yairbon/HomeGuard/README.md

# HomeGuard — מערכת אבטחה היברידית מרובת שכבות

פרויקט גמר, קורס חשיפה לחומרה. שותפים: גיא בר, יאיר בונפיל.

## תקציר
מערכת אבטחה לבית המשלבת מחשוב קצה על ESP32 עם עיבוד נתונים בפייתון.
**שלושה לוחות ESP32** (לוח חיישנים עם חיישן מרחק וחיישן רעידות, לוח דלת עם
קודן וזמזמים, ולוח מצלמה) מדווחים לבקנד FastAPI מרכזי, שמאחד את התקשורת,
מריץ זיהוי פנים, ומשרת אפליקציית Flutter לשליטה מרחוק ולהתראות. בתיקיית
`esp32/` יש גם סקיצה עצמאית לחיישן הרעידות, שלא נצרבת על לוח נפרד בהתקנה
הסופית (החיישן יושב על לוח החיישנים).

## מבנה תיקיות
- `esp32/` — קושחת C++ לבקרים (ראה `esp32/README.md`)
- `python/` — בקנד FastAPI + זיהוי פנים (ראה `python/README.md`)
- `app/` — אפליקציית Flutter (Android) לשליטה מרחוק והתראות
- `docs/` — מסמכי הפרויקט (כולל טופס ההצעה המקורי)
- `scripts/` — סקריפטי התקנה לסביבת הפיתוח (ראה למטה)

**הערה:** התיקייה ממוקמת ב-`C:\dev\HomeGuard` בכוונה (לא תחת `C:\Users\<username>`) —
כלי Android/Gradle נשברים לעיתים כשהנתיב מכיל תווים לא-ASCII (כמו שם משתמש בעברית).

## ארכיטקטורה

```
  ┌───────────────────┐   ┌──────────────────┐   ┌────────────────────────┐
  │ ultrasonic_sensor │   │ vibration_sensor │   │ door_keypad_controller │
  │    (HC-SR04)      │   │     (SW420)      │   │  קודן + חיישן דלת      │
  └─────────┬─────────┘   └────────┬─────────┘   └───────────┬────────────┘
            │  POST /esp32/*       │                         │  ▲
            │  + X-Device-Key      │                         │  │ POST /arm /disarm
            └──────────────┬───────┴─────────────────────────┘  │ /trigger-alarm
                           │                                     │ /keypad-pin
  ┌───────────────────┐    │                                     │ + X-Device-Key
  │    esp32_cam      │    │                                     │
  │  (AI-Thinker)     │────┤  POST /camera/recognize             │
  │  + שרת MJPEG      │◀───┤  ◀── GET /stream (הבקנד מושך)      │
  └───────────────────┘    ▼                                     │
                 ┌──────────────────────┐──────────────────────-─┘
                 │  בקנד FastAPI        │
                 │  (python/)           │  ← זיהוי פנים (YuNet + SFace)
                 └──────────┬───────────┘
                            │  REST + WebSocket /ws
                            │  + Authorization: Bearer <token>
                            ▼
                 ┌──────────────────────┐
                 │  אפליקציית Flutter   │
                 │  (app/, Android)     │
                 └──────────────────────┘
```

שני הלוחות הראשונים "טיפשים" בכוונה — הם לא יודעים אם המערכת דרוכה, פשוט
מדווחים, והבקנד מחליט אם זה משנה. לוח הקודן הוא הסמכות לדריכה/נטרול (יש לו
את הקודן הפיזי), ולכן הוא היחיד שגם מקבל פקודות ולא רק שולח. לוח המצלמה
דוחף פריימים לזיהוי פנים וגם מגיש זרם MJPEG שהבקנד מעביר לאפליקציה; בכוונה
הוא לא שולח heartbeat.

## אבטחה

זו מערכת אזעקה, ולכן שום endpoint לא פתוח:

- **האפליקציה** מתחברת עם סיסמה ומקבלת session token (תקף 12 שעות), שנשלח
  ככותרת `Authorization: Bearer` בכל בקשה. הסיסמה נשמרת כ-hash (scrypt עם
  salt), לא בטקסט גלוי. שינוי סיסמה מבטל את כל הסשנים האחרים.
- **הלוחות** מזדהים עם מפתח משותף (`X-Device-Key`) שמוגדר ב-`esp32/secrets.h`.
  בלעדיו אי אפשר לזייף דיווח פריצה — או לזייף דיווח "המערכת נוטרלה".
- **נעילה** אחרי 3 ניסיונות שגויים, על `/login` וגם על `/change-password`.
- ה-endpoints הפתוחים הם `/health`, `/login`, ותיעוד ה-API שלFastAPI
  (`/docs`, `/redoc`, `/openapi.json`). כל השאר דורש אישור.

**סודות לא נכנסים לגיט:** העתק את `esp32/secrets.h.example` לכל אחת
מכל תיקיית סקיצה שנצרבת על לוח בשם `secrets.h` ומלא את הערכים (פרטי WiFi, כתובת
הבקנד, מפתח המכשיר, קוד הקודן). לוח המצלמה צריך אותו כמו כל השאר — בלעדיו
הוא לא מזדהה מול הבקנד. `KEYPAD_PIN` הוא רק ברירת המחדל לצריבה: אחרי
ההתקנה אפשר לשנות את הקוד ממסך ההגדרות באפליקציה, והוא נשמר ב-NVS על הלוח.

## הרצה

בקנד:
```powershell
cd python
python -m venv venv
.\venv\Scripts\pip.exe install -r requirements.txt
.\venv\Scripts\python.exe -m uvicorn backend.main:app --host 0.0.0.0 --port 8000
```
בהרצה ראשונה הוא ייצר מפתח מכשיר וידפיס אותו ללוג — זה מה שצריך להיכנס
ל-`secrets.h`. פירוט מלא: `python/README.md`.

אפליקציה: `/flutter-build` (custom command) או ידנית דרך WSL2 (ראה "סביבת
פיתוח" למטה). את כתובת הבקנד עורכים במסך Settings באפליקציה.

## בדיקות

| מה | איך | היקף |
|---|---|---|
| בקנד, מהיר | `pytest` מתוך `python/` | 285 בדיקות in-process, בלי שרת |
| בקנד, מקצה לקצה | `python simulate.py` מול שרת **נפרד** (לא האמיתי — ראה `python/README.md`) | 95 בדיקות דרך סוקט אמיתי |
| בקנד, lint | `ruff check .` | |
| אפליקציה | `flutter analyze` + `flutter test` | |

הכול רץ אוטומטית ב-GitHub Actions (`.github/workflows/ci.yml`).

## סביבת פיתוח
Flutter SDK, Android SDK ו-JDK 17 מותקנים תחת `C:\dev`. לשחזור במחשב חדש:
`.\scripts\setup-windows.ps1`. אם הבנייה נשברת עם
`Unable to establish loopback connection` — זו תקלת Winsock ברמת המערכת;
הפתרון שעובד הוא בנייה דרך WSL2 (`scripts/setup-wsl.sh`).

## חלוקת עבודה
**שותף א' (גיא)** — ניטור היקפי: חיישן אולטרה-סוני, חיישן מגנטי לדלת.
שרת ה-Web על ה-ESP32 שתוכנן בהצעה הוחלף בבקנד ובאפליקציה. הבקנד הוכן על ידי גיא,
ובמקביל האפליקציה הוכנה על ידי יאיר, והחיבור ביניהם נעשה במשותף.

**שותף ב' (יאיר)** — הגנה פיזית: חיישן רעידות, קודן 3x4, זמזם, ניהול
סיסמאות, סינון רעשים וסף "כוח מוגזם".

## דרישות
**Must:** זיהוי חדירה (אולטרה-סוני/דלת) או פריצה בכוח; נטרול דרך קודן פיזי;
אזעקה קולית (Buzzer). — **הושלם.**

**Nice to have:** אימות ביומטרי (זיהוי פנים) — הושלם, כולל `camera_worker.py`
שמזין את המנוע ונטרול לפי פנים (opt-in); דאשבורד לוג אירועים בזמן אמת —
הושלם; שינוי סיסמה מהאפליקציה — הושלם.

**מעבר לדרישות:** התראות באימייל עם תמונה מהמצלמה, ואימייל הסלמה לאנשי קשר, שמגיעים גם כשהאפליקציה סגורה;
auto-arm מתוזמן ל-night mode; ספירה לאחור של entry delay באפליקציה.

**לא ממומש (מתועד ככזה):** חיוג טלפוני אמיתי למספר החירום — דורש ספק
טלפוניה. במקומו נשלחת התראת הסלמה דחופה שאומרת למי להתקשר.

## BOM (תקציב: 170 ש"ח)
ESP32 DevKit V1 ×2, ESP32-CAM (AI-Thinker) ×1, קודן 3x4, חיישן מגנטי MC38,
חיישן רעידות SW420, חיישן אולטרה-סוני HC-SR04, זמזם, אקססוריז. (מצלמת USB
עדיין נתמכת כחלופה דרך `python/camera_worker.py`, אבל היא לא נדרשת.)
