yairbon/HomeGuard/esp32/README.md

# HomeGuard ESP32 Firmware — 3 Boards

Four sketches, each in its own folder (Arduino IDE requires the folder name to
match the `.ino` filename — already set up that way). In the final build three
physical boards are used: board 1 also carries the vibration sensor, so board
2's standalone sketch is not flashed onto a board of its own.

| Board | Sketch | Role |
|---|---|---|
| 1 | `ultrasonic_sensor/` | HC-SR04 distance sensor — perimeter breach detection |
| 2 | `vibration_sensor/` | Digital vibration sensor (SW420-style) — forced-entry detection |
| 3 | `door_keypad_controller/` | Magnetic door sensor + keypad + buzzers — **the arm/disarm authority** |
| 4 | `esp32_cam/` | ESP32-CAM (AI-Thinker) — pushes frames for face recognition, serves the live video stream |

Boards 1 and 2 are simple: they detect a breach and POST it to the
backend. They don't know or care whether the system is armed — the
backend decides that (see `python/backend/state.py`, `trigger_alert`).
Board 1 also carries a second SW-420-style force sensor (same component as
board 2) wired straight onto it for a nearby window, so it reports both
`sensor=ultrasonic` and `sensor=vibration` (both tagged `board=ultrasonic`)
rather than needing a fourth-and-a-half board just for one more sensor.

Board 3 is different: it owns arm/disarm (it has the keypad), so it both
sends reports to the backend *and* receives commands from it (the app's
arm/disarm buttons reach this board through the backend).

Board 4 does both directions too, but for a different reason. It *pushes*
a frame every `CAPTURE_INTERVAL_MS` to `/camera/recognize` (this is what
feeds face recognition — same endpoint `python/camera_worker.py` posts to
from a PC webcam, so the backend can't tell the two apart), and it also
*serves* `/stream`, a continuous MJPEG feed the backend pulls and relays
on to the app (`/camera/stream`). Polling single JPEGs was tried first and
was far too slow to look live; MJPEG is what actually reaches a usable
frame rate. See "Board 4 — the camera" below.

## Before flashing — `secrets.h`

Copy `secrets.h.example` into **each of the four sketch folders** as
`secrets.h` and fill in the real values:

```
esp32/ultrasonic_sensor/secrets.h
esp32/vibration_sensor/secrets.h
esp32/door_keypad_controller/secrets.h
esp32/esp32_cam/secrets.h
```

Four copies rather than one shared file because the Arduino IDE compiles one
sketch folder at a time and only looks for headers inside that folder.

`secrets.h` is gitignored; only the `.example` is committed. These values —
the WiFi password, the device key, and the keypad PIN — used to be literals
in the `.ino` files, which meant they were committed to this repository in
plain text.

What goes in it:

| Setting | Where to get it |
|---|---|
| `WIFI_SSID` / `WIFI_PASSWORD` | your network |
| `BACKEND_HOST` | `ipconfig` on the machine running the backend, same WiFi as the boards |
| `DEVICE_KEY` | printed by the backend at startup, or set via `HOMEGUARD_DEVICE_KEY` |
| `KEYPAD_PIN` | your choice; only the door controller uses it — and only as the **factory default** for a board whose NVS has never been written (see below) |

### The device key

Every `/esp32/*` call now sends `X-Device-Key`, and the backend returns 401
without it. This is what stops anything else on the network from forging a
sensor breach — or forging a "system disarmed" report, which would make the
app show a false all-clear.

It works in the other direction too: the backend sends the same key to the
door controller's `/arm` and `/disarm`, and the sketch rejects commands
without it. That board listens on port 80 and `/disarm` silences a sounding
alarm, so an unauthenticated POST from anyone who found its IP would
otherwise be enough to defeat the system.

If a board logs `REJECTED (401)`, its `DEVICE_KEY` doesn't match the
backend's.

## Wiring up two-way communication with the door controller

After flashing `door_keypad_controller`, open its Serial Monitor (9600
baud) — it prints its own IP once WiFi connects. Set that as an
environment variable before starting the backend:

```powershell
$env:HOMEGUARD_DOOR_CONTROLLER_URL = "http://<that IP>"
.\venv\Scripts\python.exe -m uvicorn backend.main:app --host 0.0.0.0 --port 8000
```

Without this, the app's arm/disarm buttons still work (the backend
simulates the timing itself), they just won't reach real hardware.

### Changing the PIN after flashing

The disarm PIN set in `secrets.h` only ever applies to a board whose NVS
(flash) has never stored one. Once the app changes the password (Settings),
the new PIN is pushed to the door controller's `/keypad-pin` route and
persisted in NVS, and it survives power loss and reboots from then on —
reflashing the board with an old `secrets.h` will not revert it.

## Door controller sounds

The two buzzers (GPIO23 and GPIO22) play: a click on every key press, the
accelerating entry-delay beeps, a siren while the alarm is active, and short
status sounds for armed, disarmed (also "arming cancelled") and wrong PIN.
The entry delay lasts 30 s (`ENTRY_TIME_LIMIT`; the backend and app mirror
whatever the board reports). While someone is typing a PIN the countdown
*beeps* pause, from the first key until 1.8 s after the last one, so every key
and the wrong-PIN / disarmed result are heard on their own; the 30 s timer
itself never pauses. The siren alternates the two buzzers. Priority is siren >
entry beeps > status sounds > clicks. Sound code never
blocks `loop()`: it runs on its own task, and `setState()` is the single place
that starts the sounds tied to a state change, so they play the same whether
the change came from the keypad, the app or `/trigger-alarm`.

Arming is refused while the door is open: the keypad's `*` prints "Door must be
closed first" and plays a distinct refusal sound (a rapid four-pulse stutter),
and the app's arm command is answered `409` so the backend arms nothing and the
app shows "Can't arm: the door is open. Close it and try again."

Every duration and pitch is in the `SOUNDS` block at the top of
`door_keypad_controller.ino`. The buzzers are treated as **active** (fixed
pitch, so sounds differ by rhythm and by which buzzer plays); building with
`BUZZERS_ACTIVE 0` plays the table's Hz values as real pitches for passive
piezos instead.

## Testing the keypad at a desk

The 3x4 keypad is wired and read directly (`getPhysicalKey()`). Characters
typed into the Serial Monitor (9600 baud) are also accepted as key presses
(`getSimulatedKey()`) **only in a bench build**, compiled with
`--build-property build.extra_flags=-DENABLE_SERIAL_KEYPAD=1`; the shipped
build ignores USB input, so nobody with a cable can type at the panel. In a
bench build `*` arms and digits + `#` submit a PIN (whatever is stored, or the
`KEYPAD_PIN` default in `secrets.h`).

## Heartbeats

Each *sensor* board pings `/esp32/heartbeat?board=<name>` every 10 seconds,
using the name the backend knows it by (`ultrasonic`, `vibration`,
`door_controller` — see `BOARD_NAMES` in `python/backend/state.py`). The
backend marks a board offline after 30 seconds of silence and the app names it
on the dashboard, so a board that loses power is visible rather than silently
uncovered. The ultrasonic board's heartbeat can also carry an optional
`&fault=` (e.g. `baseline_rejected`, `baseline_moved`, `no_echo`) when its
last distance-calibration attempt didn't go cleanly — see the baseline
sanity-check comments in `ultrasonic_sensor.ino`.

The camera board (4) is the exception: it sends no heartbeat, because its
frame pushes already are one. Every `/camera/recognize` POST calls
`state.set_camera_online(True)` on arrival — a board that's sending frames is
by definition alive, so a separate liveness ping would be redundant traffic.

## Board 4 — the camera (ESP32-CAM)

Two independent jobs, on two independent paths:

1. **Face recognition (push).** `sendFrame()` in `loop()` POSTs one JPEG to
   the backend's `/camera/recognize` every `CAPTURE_INTERVAL_MS`, with the
   shared device key. Byte-for-byte the same request `python/camera_worker.py`
   sends from a PC webcam, so the backend needs no special case for it.
2. **Live view (pull).** `startCameraServer()` serves `/stream` — a
   `multipart/x-mixed-replace` MJPEG feed. The backend connects to it and
   relays the bytes on to the app (`/camera/stream` in
   `python/backend/main.py`), so the phone never talks to this board directly
   and the feed works from anywhere the backend is reachable, not just on
   the local WiFi.

The stream server uses **`esp_http_server`, not Arduino's `WebServer`** — and
that's load-bearing, not a style choice. `httpd_start()` runs the handler on
its own FreeRTOS task, so `streamHandler`'s per-client infinite loop never
touches `loop()`. With Arduino's `WebServer`, `handleClient()` would block
inside that handler for the whole streaming session, starving `sendFrame()`
completely for as long as anyone was watching — face recognition would stop
the moment someone opened the camera tab.

`/stream` checks the same device key, as an `X-Device-Key` header (what the
backend sends) or a `?key=` query param (a browser or VLC generally can't set
a custom header). Note the tradeoff this inherits from the project's existing
trust model: the key that views the stream is the same key that can report a
sensor breach.

`initCamera()` sets `grab_mode = CAMERA_GRAB_LATEST` with `fb_count = 2` on
purpose. Two consumers now pull frames concurrently (the stream task and
`sendFrame()`); `CAMERA_GRAB_LATEST` drops stale frames instead of queuing
them, so a slow consumer doesn't accumulate lag over a long-lived stream. On a
board without PSRAM the fallback is `fb_count = 1`, where those two consumers
contend for a single buffer and roughly halve each other — don't run both
features on a PSRAM-less module.

### Frame rate

Measured with the previous sketch (VGA, JPEG quality 12, picture brightness
about 120/255): 18-20 frames/s straight from the board, and 19.9-20.0 per viewer
through the backend's camera hub with one viewer or two, so the relay loses
nothing and the board is the limit. Three things held it back, and the sketch now
handles each:

- **WiFi modem sleep** (the default) lets the radio doze between the router's
  beacons. `connectWiFi()` calls `WiFi.setSleep(false)` and prints
  `WiFi power save: off` at boot. With it on, ping time to the board was 5-80 ms
  and the worst gap between stream frames was 717 ms (340 ms with it off, in a dim
  room).
- **TCP waiting for small packets** (Nagle plus the receiver's delayed
  acknowledgements) made frames arrive in bursts with holes between them.
  `streamHandler()` sets `TCP_NODELAY` on its socket.
- **Three chunk sends per frame** (boundary, part header, JPEG) are now one: the
  three are copied into one PSRAM buffer and sent together, and the camera's
  frame buffer goes back to the driver right after the copy. If the buffer cannot
  be allocated, or a frame does not fit, it falls back to the three sends.

The face-recognition push now runs every 300 ms measured from the start of one
push to the start of the next (it used to wait 500 ms after the backend's reply,
which made it about 1.3 a second). Raising it did not slow the stream in earlier
tests.

The sensor itself limits what is possible: with a 20 MHz clock the OV2640 tops
out around 25 frames/s in this mode in good light, and in a dim room the exposure
time dominates and it drops to about 16 whatever the firmware does. **These
changes compile on core 3.3.11 but had not been flashed or measured on the board
when this was written** — flash it, then count frames on `/stream` before
trusting the numbers above.

### Flashing it is different from the other three

The AI-Thinker ESP32-CAM has no auto-reset circuit, so a normal upload fails
with `Failed to connect to ESP32: No serial data received`. It has to be put
into bootloader mode by hand, every time:

1. Hold **BOOT** (IO0) down
2. Press and release **RESET** while still holding BOOT
3. Release BOOT
4. Start the upload immediately

After the upload finishes, press **RESET** alone to run the new firmware —
the post-flash auto-reset doesn't fire on this board either.

It also needs its own FQBN — `esp32:esp32:esp32cam`, not `esp32:esp32:esp32`.

`setup()` disables the brownout detector (`RTC_CNTL_BROWN_OUT_REG`) because
these modules are well known to brown out on the camera's init current spike
over a marginal USB cable. Worth remembering that this also *masks* a real
brownout during sustained streaming — which draws far more current, for far
longer, than the old interval capture did — so a hang or reset under load is a
power problem until proven otherwise.

## Verifying changes still compile

```powershell
& "C:\Program Files\Arduino CLI\arduino-cli.exe" compile --fqbn esp32:esp32:esp32 <sketch-folder>
```

(Requires `arduino-cli core install esp32:esp32` once, already done on
this dev machine.) Board 4 needs `--fqbn esp32:esp32:esp32cam` instead.
