yairbon/HomeGuard/report/HomeGuard_Report_DRAFT.pdf

## הפקולטה להנדסה המחלקה להנדסת חשמל ומחשבים

# פרויקט גמר

קורס חשיפה לחומרה

# HomeGuard

## מערכת אבטחה היברידית מרובת שכבות

בקרי 32ESP, בקנד ב-Python ואפליקציה לטלפון

תאריך הביצוע: 20/10/26
תאריך ההגשה: 21/10/26
| שותף א' שותף ב'
| גיא בר יאיר אברהם בונפיל | שמות המבצעים:
| | מספר זהות: 213263932 325534121
yairbonfil@mail.tau.ac.il | guybar1@mail.tau.ac.il | :ל"דוא

שמות המנחים: אריאלה צברי, עידן הבר

## .1 תקציר

בפרויקט נבנתה מערכת אזעקה לבית. שלושה בקרי 32ESP( בקר חיישנים עם חיישן מרחק וחיישן רעידות, בקר דלת עם חיישן דלת, קודן וזמזמים, ובקר מצלמה( מחוברים ב-WiFi לשרת )בקנד( שכתוב ב-Python ורץ על מחשב. הבקנד מחליט, על סמך דיווחי הבקרים, מתי יש אזעקה, מזהה פנים של דיירים ושולח אימייל עם תמונה ועם סרטון מהמצלמה. אפליקציה בטלפון מאפשרת לדרוך, לנטרל, לראות את המצלמה ולעבור על יומן אירועים, ואפשר לדרוך ולנטרל גם מהקודן שליד הדלת.

המערכת נבדקה על החומרה בתרחישי דריכה, כניסה, חדירה ונטרול. דרישות החובה מומשו. שני דברים מההצעה לא מומשו כפי שהוצעו: אזעקה אחרי כמה קודים שגויים בקודן הפיזי, והפעלת אזעקה בזיהוי פנים לא מאושרות. המסקנה העיקרית היא שהפרדה בין בקרים פשוטים, שרק מדווחים, לבקנד שמחליט מאפשרת לשנות התנהגות בלי לטעון מחדש את התוכנה לבקרים.

## .2 מבוא

### 2.1 הרעיון והמטרות

הפרויקט נבחר כדי לשלב חומרה ותוכנה: כמה חיישנים שונים, כדי להתנסות בכל אחד מהם, ותוכנה שמחברת אותם למערכת אזעקה אחת. המערכת היברידית, כלומר חלק מהעבודה נעשה בבקרים הקטנים וחלק במחשב, ומרובת שכבות: כמה סוגי חיישנים, קודן וזיהוי פנים.

הבעיה: לזהות חדירה לבית ולהגיב אליה בסירנה ובהתראה לבעלים, תוך שילוב כמה סוגי חיישנים, נטרול בקודן ובטלפון וזיהוי של דיירים. הדוח מציג את הרקע התיאורטי )פרק 3(, את התכנון והמימוש )פרק 4(, את הבדיקות והתוצאות )פרק 5( ואת הסיכום )פרק 6(.

המטרות, לפי הצעת הפרויקט:

- זיהוי חדירה )חיישן מרחק או חיישן דלת( וזיהוי ניסיון פריצה בכוח )חיישן רעידות(.
- נטרול באמצעות קודן פיזי.
- אזעקה קולית.
- בנוסף: זיהוי פנים של דיירים, יומן אירועים בטלפון ושינוי הקוד מהאפליקציה.

### 2.2 מה המערכת עושה

המערכת יכולה להיות דרוכה או מנוטרלת. כשהיא דרוכה, אזעקה מופעלת בארבעה מקרים: הדלת נפתחת ולא מנטרלים בזמן, מישהו עובר מול חיישן המרחק, חיישן הרעידות מזהה מכה, או שמוקלדות שלוש סיסמאות שגויות באפליקציה. באזעקה הזמזמים משמיעים סירנה,

האפליקציה מציגה אזעקה ונשלח אימייל עם תמונה מהמצלמה, ולפי הגדרה באפליקציה גם עם סרטון. דורכים ומנטרלים מהקודן שליד הדלת או מהאפליקציה.

### 2.3 שינויים לעומת הצעת הפרויקט

- חיישן הלייזר הוחלף בחיישן מרחק אולטרה-סוני.
- במקום מצלמת USB שמחוברת למחשב נעשה שימוש ב-CAM32-ESP.
- במקום שרת Web על ה32-ESP נבנו בקנד על מחשב ואפליקציה לטלפון.
- במקום בקר אחד יש שלושה בקרי 32ESP, ולכל אחד תפקיד משלו.
- ההתראות נשלחות באימייל.
- קודן 3×4 במקום 4×.4
- חיישן הרעידות מחובר כאות דיגיטלי עם פסיקה ולא כאות אנלוגי. לכן במקום אלגוריתם לסינון אות אנלוגי נעשה סינון של קריאות חוזרות והפסקה בין דיווחים )סעיף 3.5(.
- חיישן המרחק וחיישן הדלת נקראים בסריקה חוזרת של הבקר ולא בפסיקות. פסיקה משמשת רק לחיישן הרעידות.
- במקום מערך סיסמאות נשמר קוד אחד, בזיכרון הקבוע של בקר הדלת, והוא גם הסיסמה לאפליקציה.
- זיהוי פנים משמש לנטרול המערכת, באופט-אין, ולא להפעלת אזעקה בזיהוי פנים לא מאושרות.
- אזעקה אוטומטית אחרי 3 קודים שגויים לא מומשה בקודן הפיזי, והיא קיימת רק בהתחברות לאפליקציה )טבלה 6(.

### 2.4 חלוקת עבודה

שותף א' )גיא בר( אחראי על הניטור ההיקפי: חיישן המרחק וחיישן הדלת. שותף ב' )יאיר בונפיל( אחראי על ההגנה הפיזית: חיישן הרעידות, הקודן והזמזם, וניהול הסיסמאות. במקביל, הבקנד הוכן על ידי גיא והאפליקציה הוכנה על ידי יאיר. החיבור בין החלקים נעשה במשותף.

## .3 רקע תיאורטי

### 3.1 הבקר 32ESP

32ESP הוא מיקרו-בקר זול עם WiFi מובנה [1]. מתכנתים אותו ב-C++ בסביבת [2] Arduino. לבקר זיכרון וכוח עיבוד מוגבלים, ולכן זיהוי הפנים נעשה במחשב ולא בבקר.

### 3.2 החיישנים והקודן

חיישן מרחק )04SR-HC). החיישן שולח פולס קול ומודד כמה זמן עובר עד שההד חוזר. המרחק הוא:

d=

v ⋅ Δt
2

כאשר s/m343 ≈ v היא מהירות הקול ו-Δt הוא זמן ההלוך והשוב. החלוקה ב2- נובעת מכך שהקול עובר את הדרך פעמיים [3].

חיישן רעידות )-420SW). מודול שנותן אות דיגיטלי כשיש רעידה. האות מתקבל ממשווה מסוג .LM393 [4]

חיישן דלת. מתג מגנטי )switch Reed): מגנט על הדלת וחיישן על המשקוף. כשהדלת נפתחת המגנט מתרחק והמתג נפתח.

קודן. בקודן 12 לחצנים: הספרות 0–,9 * ו.#- הלחצנים מסודרים ב4- שורות ו3- עמודות. כל לחצן, כשלוחצים עליו, מקצר בין חוט של שורה לחוט של עמודה. לכן מספיקים 7 חוטים )4 + 3( במקום .12 כך הבקר מזהה איזה לחצן נלחץ [5]:

.1 שורה אחת בכל פעם מורדת ל-LOW( מתח נמוך(, והשאר נשארות ב-HIGH( מתח גבוה(.

.2 הבקר קורא את שלוש העמודות. במצב רגיל הן ב-HIGH.

.3 אם עמודה נקראת LOW, נלחץ הלחצן שנמצא בצומת של השורה הזאת והעמודה הזאת.

הבקר עובר על ארבע השורות שוב ושוב, הרבה פעמים בשנייה.

### 3.3 זיהוי פנים

זיהוי פנים נעשה בשני שלבים. קודם מוצאים את הפנים בתמונה )[6] YuNet). אחר כך הפנים הופכות לווקטור של מספרים ומשווים אותו לפנים ששמורות במערכת )[7] SFace). שני המודלים רצים בספריית [8] OpenCV.

### 3.4 תקשורת

הבקרים שולחים לבקנד בקשות HTTP. האפליקציה שולחת פקודות לבקנד, שכתוב ב-
[9] FastAPI, ומקבלת ממנו עדכונים חיים דרך WebSocket .]10 [WebSocket הוא חיבור שנשאר פתוח, והבקנד דוחף דרכו כל שינוי ברגע שהוא קורה. בלי זה האפליקציה הייתה צריכה לשאול את הבקנד כל כמה שניות אם משהו השתנה, והאזעקה הייתה מופיעה בעיכוב. האימייל נשלח מהבקנד בפרוטוקול [11] SMTP.

### 3.5 סינון רעש

חיישנים מחזירים לפעמים קריאות שגויות. חיישן מרחק עלול לקלוט הד מקרי, ולחצן מכני "קופץ" כמה פעמים לפני שהוא מתייצב. אם כל קריאה כזו הייתה מפעילה פעולה, המערכת הייתה מפעילה אזעקות שווא. לכן נעשה שימוש בשלושה כללים פשוטים:

- נדרשות כמה קריאות חריגות ברצף לפני דיווח על חדירה.
- לחיצות חוזרות על אותו לחצן בפרק זמן קצר אינן נספרות )debounce).
- אחרי דיווח מתקיימת המתנה של כמה שניות לפני הדיווח הבא, כדי שאירוע אחד לא יציף את הבקנד.

הסעיפים 4.2 ו4.10- מראים איך זה מומש במערכת.

## .4 תכנון ומימוש

### 4.1 מבנה המערכת

המערכת בנויה משלושה בקרי 32ESP, בקנד ואפליקציה )איור 1(. לבקרים מחוברים החיישנים, והם שולחים הודעות לבקנד ב-WiFi. הבקנד שומר את מצב המערכת )סעיף 4.3( ומחליט, על סמך דיווחי בקרי החיישנים, אם זו אזעקה. בקרי החיישנים רק מדווחים, ולכן אפשר לשנות התנהגות )למשל מצב Home )בבקנד, בלי לטעון מחדש את התוכנה לבקרים )צריבה(. בקר הדלת מקבל גם פקודות מהבקנד, כי בו נמצאים הקודן והזמזמים, והוא מחזיק גם את מכונת הדריכה, את ספירת הכניסה ואת הסירנה. לכן הסירנה מופעלת גם בלי הבקנד כשהדלת נפתחת ולא מנטרלים בזמן. הרכיבים והחיבורים של כל בקר מפורטים בטבלה .1

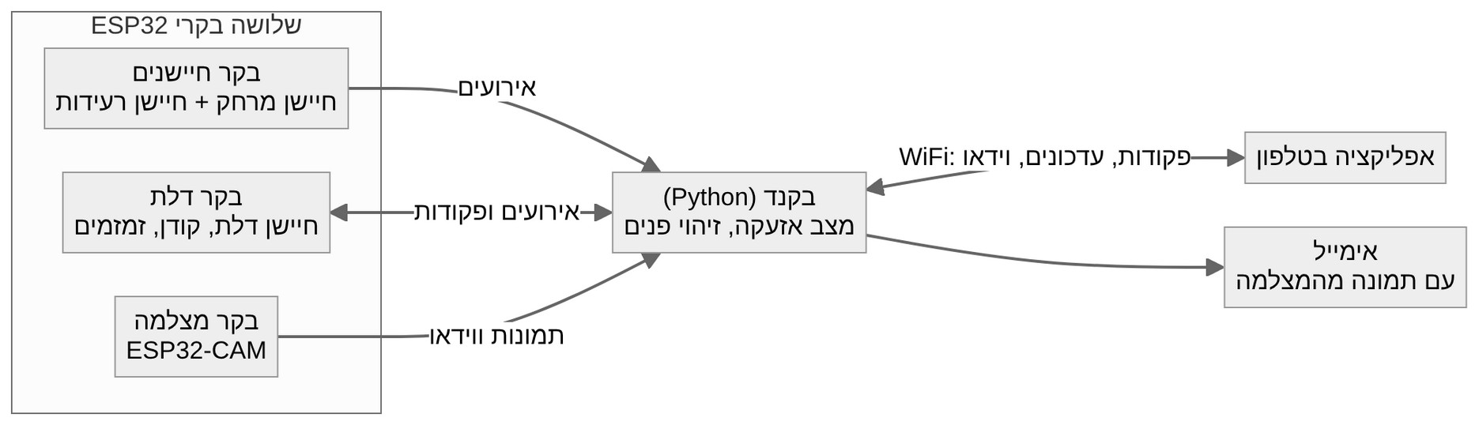
[picture p12: figure]

איור :1 מבנה המערכת

טבלה :1 הבקרים במערכת

| | | בקר רכיבים חיבורים )GPIO )תפקיד
מדווח לבקנד על חדירה או מכה | חיישן .TRIG: 14. ECHO: 12 רעידות: 27 | חיישן מרחק )-HC 04SR), חיישן רעידות )-420SW) | בקר חיישנים
דריכה ונטרול, צלילים | חיישן דלת: .4 זמזמים: 23 ו.22-שורות הקודן: ,25 ,13 ,12 .27 עמודות הקודן: ,26 ,33 14 | חיישן דלת, קודן, שני זמזמים | בקר דלת
שולח תמונות לזיהוי פנים ווידאו חי לאפליקציה | | CAM32-ESP חיבורי המצלמה הקבועים של הלוח | בקר מצלמה

### 4.2 החומרה

מספרי ה-GPIO בטבלה 1 הם הפינים בלוח שאליהם מחובר כל רכיב. חיישן הדלת ועמודות הקודן מוגדרים עם נגד משיכה פנימי )PULLUP_INPUT), כך שהפין נקרא HIGH כשאין לחיצה או כשהדלת סגורה, ו-LOW כשהמגע נסגר.

בקר החיישנים. בהפעלה הבקר מודד את המרחק לקיר או למסדרון שמולו, ממוצע של 10 קריאות, וזה המרחק הרגיל. המרחק נשמר בזיכרון הקבוע של הבקר, כדי שיהיה לבקר מרחק רגיל להסתמך עליו אם המדידה בהפעלה הבאה תיכשל. אחר כך הבקר מודד בתדר של כ15-Hz . כשהמרחק קצר מהרגיל ביותר מ-cm 10 בחמש קריאות ברצף, כלומר כ-s ,0.33 נשלחת לבקנד הודעת חדירה. קריאה בודדת נחשבת רעש ולא מפעילה אזעקה )איור 2 וקטע קוד 1(. אחרי דיווח הבקר ממשיך למדוד אבל מחכה s 5 לפני הדיווח הבא.

חיישן הרעידות מחובר לפסיקה )Interrupt). מכה נמשכת אלפיות שנייה בודדות, ובדיקה מדי פעם הייתה יכולה לפספס אותה. עם פסיקה הבקר מסמן את המכה ברגע שהחיישן משדר, והלולאה הראשית מדווחת עליה. גם כאן יש הפסקה של s 5 בין שני דיווחים.

במצב plot, שמופעל כברירת מחדל, בקר החיישנים מדפיס רק שורות של base ,dist ו-thr )המרחק, המרחק הרגיל והסף(, כדי ש-Plotter Serial יצייר אותן כגרף. שליחת התו p ב-Monitor Serial מחליפה בין המצב הזה להדפסות הרגילות.

בקר הדלת מתחבר לנקודת הגישה החזקה ביותר מבין כמה נקודות עם אותו שם רשת, וחיסכון החשמל של ה-WiFi כבוי, כדי שחבילות לא יתעכבו. כשהרשת נעלמת, הבקר מנסה להתחבר מחדש כל s ,20 ואחרי 5 דקות של ניתוק הוא מאתחל את עצמו, אבל רק כשהמערכת מנוטרלת, כי אתחול משכיח את מצב הדריכה.

לבקר הדלת תוכננה גם קופסה להדפסה בתלת-ממד: מגש ומכסה עם חלון לקודן. קבצי ה-
.בו | שנקבעות | מידות | לפי | Python (docs/enclosure/make_box.py) | בסקריפט | נוצרים | STL

בקר החיישנים ובקר הדלת שולחים לבקנד "דיווח חיים" )heartbeat )כל s ,10 וכך הבקנד יודע שהם מחוברים. בקר המצלמה לא שולח דיווח כזה: התמונות שהוא שולח משמשות כדיווח חיים. לכל בקשה לבקנד מוגדרת מגבלת זמן של s ,1 כדי שבקשה שנתקעה לא תעצור את המדידה.

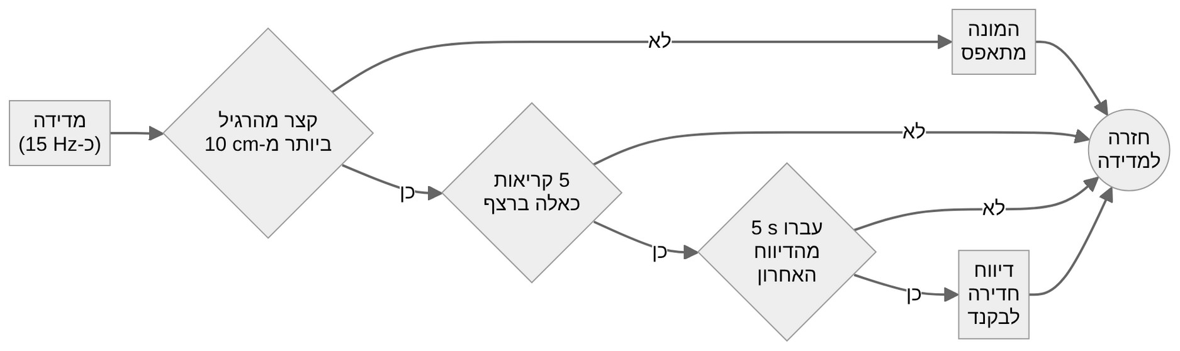
[picture p13: figure]

איור :2 זיהוי חדירה בחיישן המרחק, אחרי שהמרחק הרגיל נמדד

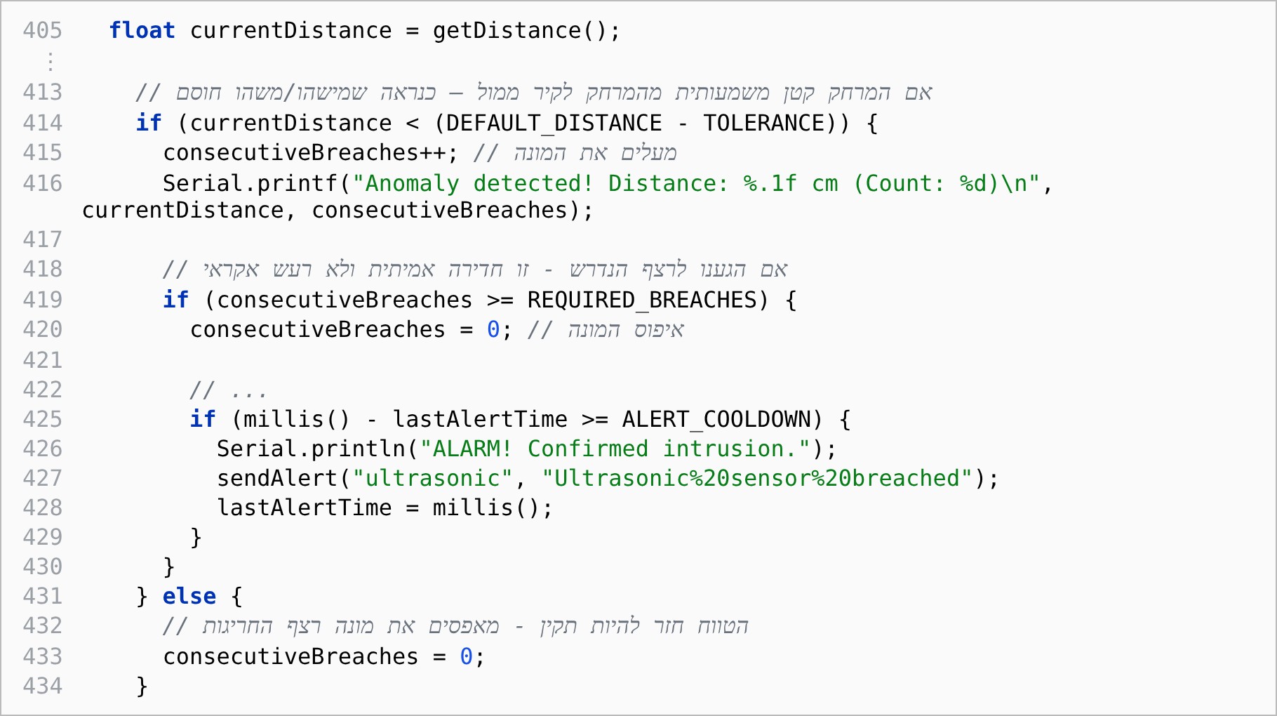
[picture p14: figure]

קטע קוד :1 זיהוי חדירה בחיישן המרחק

בקר הדלת והקודן. בקר הדלת קורא את חיישן הדלת והקודן, מפעיל את הזמזמים ומחליט אם המערכת דרוכה. הקודן נסרק כמו שמתואר בסעיף 3.2 )קטע קוד 2(. בנוסף, כל לחיצה נספרת פעם אחת בלבד: צריך להרים את האצבע לפני שאותו לחצן נספר שוב, ובין שתי לחיצות עוברים לפחות ms .200 בלי זה לחיצה אחת נקראת עשרות פעמים, כי הסריקה רצה הרבה יותר מהר מהאצבע. הקוד מורכב מ4- עד 8 ספרות. מקלידים אותו ומאשרים עם .# הדיווח לבקנד נעשה ברקע, כדי שהבקר ימשיך לסרוק את הקודן ולהגיב לפקודות גם כשהרשת איטית.

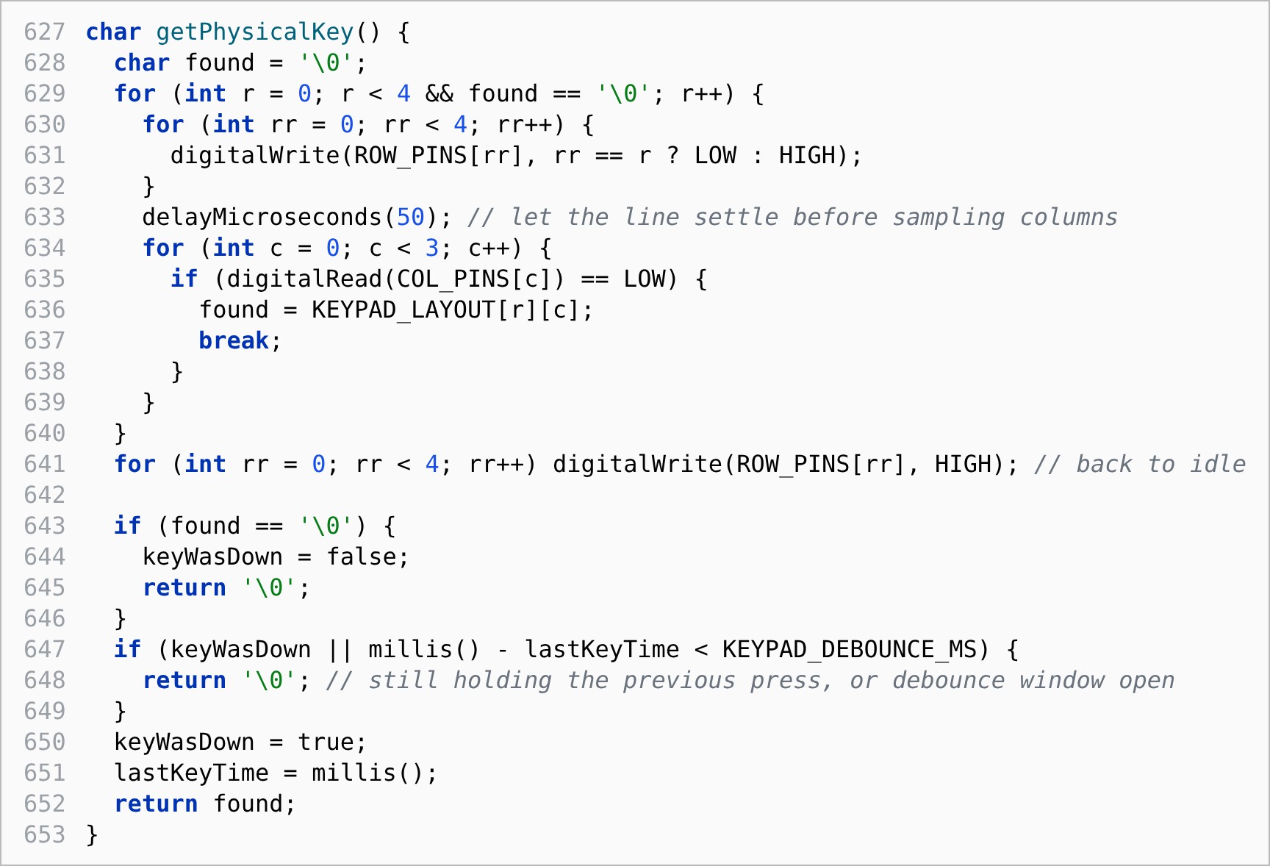
[picture p15: figure]

קטע קוד :2 סריקת הקודן

בקר המצלמה. ה-CAM32-ESP שולח תמונה לבקנד כמה פעמים בשנייה לזיהוי פנים, ומגיש גם וידאו חי שהבקנד מעביר לאפליקציה. המצלמה מגישה את הווידאו לצופה אחד בלבד, ולכן הבקנד מתחבר אליה פעם אחת ומפיץ את הווידאו לכל מי שצופה. אם הבקנד לא נגיש, המצלמה מנסה שוב בהפסקות שהולכות וגדלות, ואם עשרות תמונות ברצף נכשלות היא מאתחלת את עצמה.

הזמזמים. בבקר הדלת שני זמזמים. הם משמיעים צלילים שונים לפי מה שקורה )טבלה 2(.

טבלה :2 הצלילים של בקר הדלת

| צליל מתי
| קליק קצר בכל לחיצה על הקודן
המערכת נדרכה | שני צפצופים קצרים וצפצוף ארוך
| צפצוף ארוך ושני קצרים המערכת נוטרלה
| זמזום ארוך אחד הוזן קוד שגוי
| רצף מהיר של צפצופים קצרים אי אפשר לדרוך כי הדלת פתוחה
ספירת הכניסה, אחרי שהדלת נפתחה במערכת דרוכה. הצפצופים מתחילים אחרי s 2 ונעצרים בזמן הקלדה | צפצופים שהולכים ומתמהרים
אזעקה | סירנה )שני הזמזמים מתחלפים(

איור 3 מראה את המערכת המורכבת על דגם מקרטון: ה-CAM32-ESP על הדופן החיצונית, ולוח הניסוי עם הבקר והחיישנים בתוך הדגם.

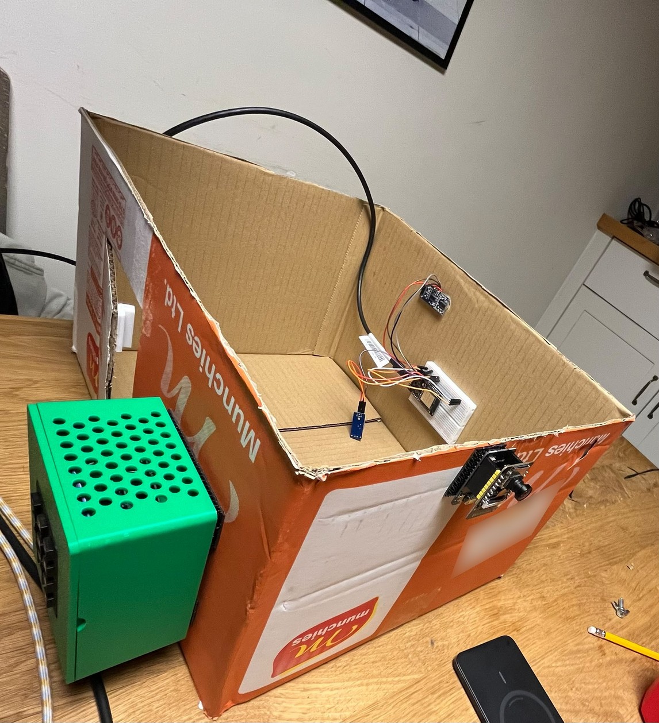
[picture p16: figure]

איור :3 המערכת בפועל על דגם מקרטון

### 4.3 דריכה, נטרול ואזעקה

המערכת עוברת בין חמישה מצבים )איור 4(: מנוטרלת, בדריכה )מהפעלת הדריכה ועד שהמערכת דרוכה(, דרוכה, ספירת כניסה ואזעקה.

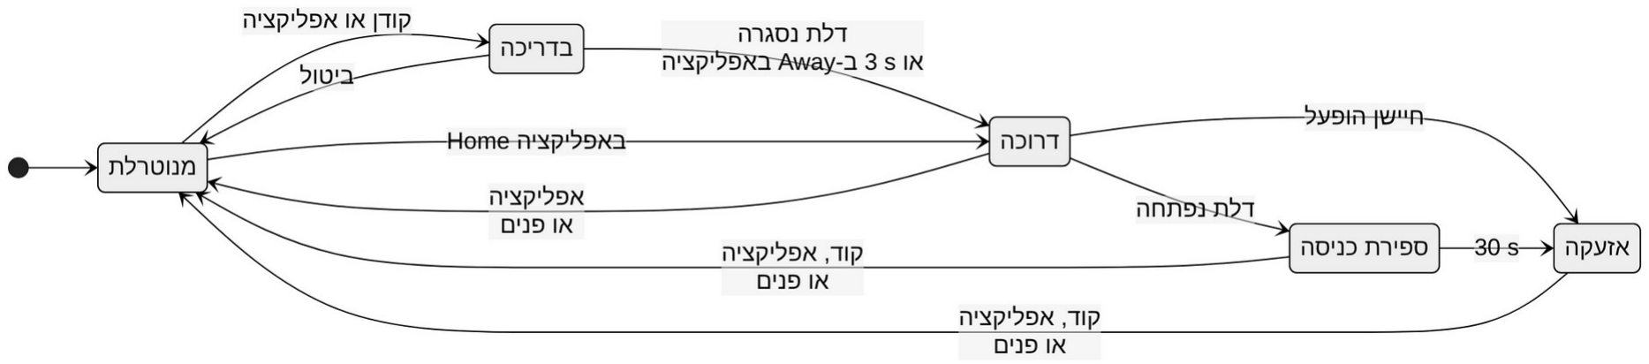
[picture p17: figure]

איור :4 מצבי המערכת. בבקר הדלת שלבי הדריכה נפרדים, והם מוצגים כאן כמצב אחד

דריכה מהקודן. לוחצים * כשהדלת סגורה, יוצאים וסוגרים את הדלת. המערכת נדרכת ברגע שהדלת נסגרת. אם הדלת פתוחה כשלוחצים *, הבקר מסרב ומשמיע צליל סירוב. לחיצה נוספת על * לפני שהדלת נסגרה מבטלת את הדריכה. הסדר הזה, לחיצה, פתיחה וסגירה, נועד לוודא שמי שדורך אכן יצא מהבית לפני שהמערכת נדרכת.

דריכה מהאפליקציה. האפליקציה שולחת פקודה לבקר הדלת, במצב Away המערכת נדרכת אחרי ספירה קצרה של s 3 שבמהלכה האפליקציה מציגה "Arming". במצב Home אין ספירה, כי מישהו נשאר בבית ואין מי שיצא, והמערכת נדרכת מיד. אם הדלת פתוחה, הדריכה נדחית והאפליקציה מציגה הודעה.

מצב Home ומצב Away. ב-Away כל החיישנים פעילים. ב-Home המערכת מתעלמת מחיישן המרחק ומחיישן הרעידות, כדי שאפשר יהיה לנוע בבית כשהמערכת דרוכה. חיישן הדלת ממשיך לעבוד.

כניסה. כשהדלת נפתחת במערכת דרוכה מתחילה ספירה של s ,30 והאפליקציה מציגה אותה. בקר הדלת מדווח כמה שניות נותרו, והאפליקציה סופרת לפי זמן סיום קבוע, כך שהספירה מדויקת גם כשהרשת איטית. בזמן הזה מקישים את הקוד ו#- )קטע קוד 3(. אם לא מנטרלים בזמן, מופעלת אזעקה.

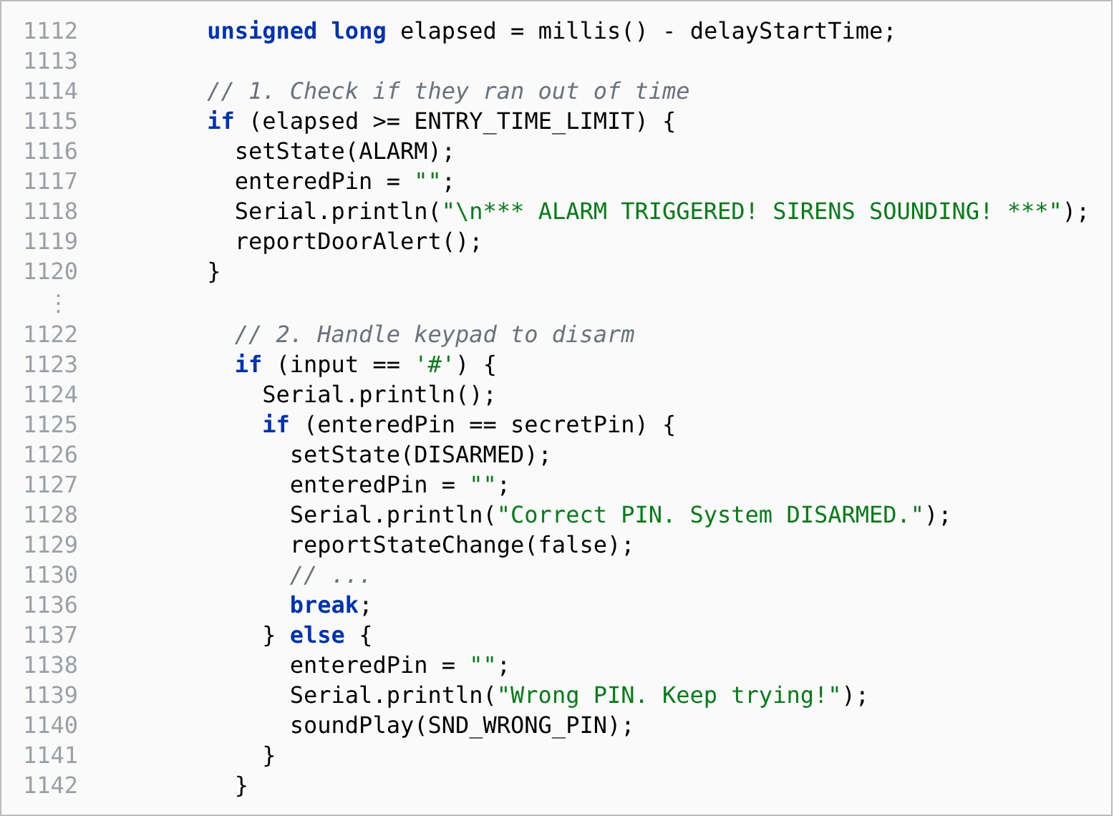
[picture p18: figure]

קטע קוד :3 ספירת הכניסה בבקר הדלת

נטרול. מנטרלים עם קוד נכון בקודן, מהאפליקציה או בזיהוי פנים. בקודן הקוד פועל רק אחרי שהדלת נפתחה )בספירת הכניסה( או כשהאזעקה כבר פועלת. הקשת קוד כשהמערכת דרוכה והדלת סגורה לא עושה דבר. נטרול בזיהוי פנים כבוי כברירת מחדל, וצריך להפעיל אותו באפליקציה. הוא נועד לנוחות ולא לאבטחה.

שינוי הקוד. את הקוד של הקודן משנים מהאפליקציה, במסך ההגדרות. הבקנד שולח את הקוד החדש לבקר הדלת, והבקר שומר אותו בזיכרון הקבוע שלו ומשתמש בו מאותו רגע. הקוד של הקודן הוא גם הסיסמה להתחברות לאפליקציה, ולכן שינוי אחד מחליף את שניהם. אם בקר הדלת לא מחובר בזמן השינוי, הקוד החדש נשמר בבקנד, והבקנד שולח אותו אוטומטית לבקר כשהוא חוזר להיות מחובר.

אזעקה. הזמזמים משמיעים סירנה, האפליקציה מציגה אזעקה ונשלח אימייל עם תמונה מהמצלמה, ולפי הגדרה באפליקציה גם עם סרטון של הדקה האחרונה )איור 5(. אם האזעקה לא נוקתה אחרי זמן שמוגדר באפליקציה, נשלח אימייל נוסף לאיש קשר לחירום.

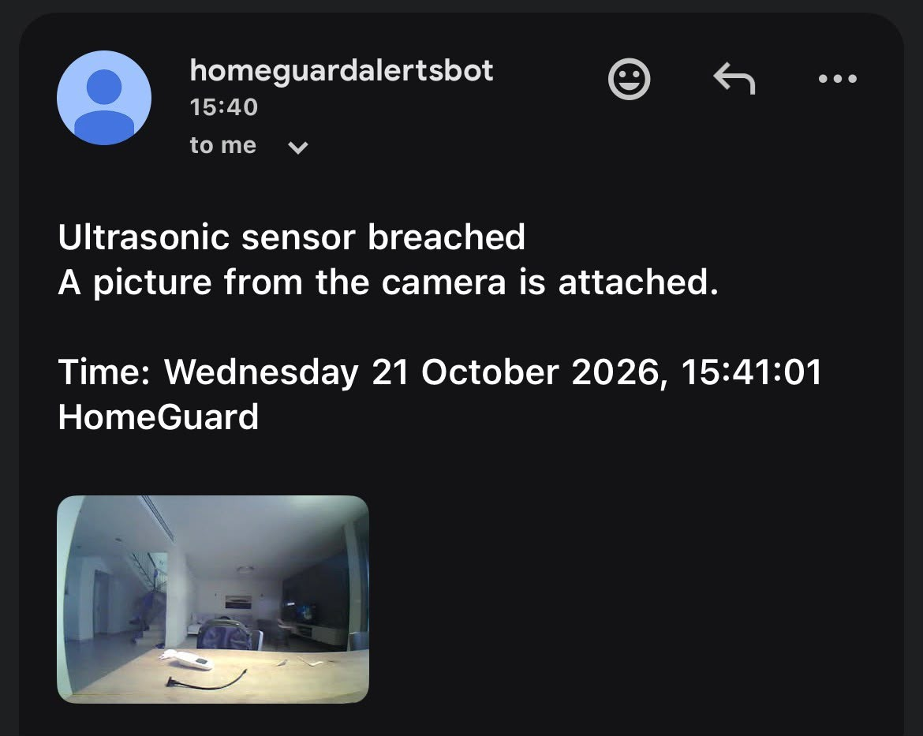
[picture p19: figure]

איור :5 אימייל התראה על חדירה בחיישן המרחק, עם תמונה מהמצלמה

### 4.4 מה קורה בזמן חדירה

דוגמה: מישהו עובר מול חיישן המרחק כשהמערכת דרוכה ב-Away.

.1 חיישן המרחק קורא כמה קריאות ברצף שקצרות בהרבה מהרגיל.

.2 בקר החיישנים שולח לבקנד הודעת חדירה.

.3 הבקנד בודק שהמערכת דרוכה ושהחיישן לא מוחרג )ב-Home מוחרגים חיישן המרחק וחיישן הרעידות(, ועובר למצב אזעקה.

.4 הבקנד מעדכן את האפליקציה, שולח אימייל עם תמונה מהמצלמה )ולפי ההגדרה גם עם סרטון( ושולח לבקר הדלת פקודה להפעיל את הסירנה.

.5 הסירנה נעצרת כשמנטרלים, בקוד בקודן או מהאפליקציה.

העדכון לאפליקציה נשלח קודם, ושליחת האימייל לא עוצרת אותו, כדי שהאזעקה תופיע מיד גם אם האימייל איטי. אם בקר הדלת מפסיק לענות באמצע ספירת הכניסה )למשל נותק מהחשמל(, הבקנד מפעיל אזעקה בעצמו, s 5 אחרי שהספירה אמורה להסתיים. האפליקציה מציגה אזעקה ונשלח אימייל, אבל הסירנה לא תושמע, כי היא יושבת על אותו בקר.

### 4.5 הבקנד

הבקנד הוא תוכנית Python שרצה על המחשב. הוא:

- שומר את מצב המערכת ואת יומן האירועים;
- מקבל דיווחים מהבקרים ומחליט אם יש אזעקה;

- בודק שהבקרים חיים: בקר החיישנים ובקר הדלת מדווחים כל כמה שניות, ובקר המצלמה נבדק לפי התמונות שהוא שולח. אם אין דבר כ-s ,30 האפליקציה מציגה שהבקר לא מחובר;
- מזהה פנים בתמונות מהמצלמה )סעיף 4.7(;
- שומר בזיכרון את הדקה האחרונה של וידאו המצלמה, כדי לצרף סרטון לאימייל )סעיף ;)4.8
- שולח אימייל באזעקה, ואימייל נוסף לאיש קשר לחירום אם האזעקה לא נוקתה )סעיף ;)4.8
- דורך ומנטרל אוטומטית בשעות הלילה )סעיף 4.8(.

הבקנד שומר בקובץ במחשב את גיבוב הסיסמה, את קוד הקודן )בטקסט גלוי, כי הוא נשלח לבקר הדלת(, את הפנים הרשומות, את ההגדרות ואת יומן האירועים, כך שהם נשמרים גם אחרי הפעלה מחדש. מצב הדריכה לא נשמר בכוונה )סעיף 5.4(.

הבקנד מגיש את הנתונים לאפליקציה בשתי דרכים. פקודות ושאילתות, כמו דריכה, נטרול ובקשת יומן, עוברות בבקשות HTTP רגילות. עדכונים שקורים מעצמם, כמו התחלת אזעקה או ניתוק בקר, נדחפים לאפליקציה דרך WebSocket, ולכן המסך מתעדכן מיד.

### 4.6 האפליקציה

האפליקציה נכתבה ב-[12] Flutter ורצה על טלפון Android. העיצוב כהה, בסגנון לוח בקרה, ומצב המערכת מובחן בצבע: אדום כשהמערכת דרוכה או באזעקה, וירוק כשהיא מנוטרלת. מצבי הביניים, דריכה בתהליך וספירת כניסה, מוצגים בצבע אזהרה משלהם. האפליקציה כוללת שישה מסכים. איור 6 מראה שלושה מהם. הממשק באנגלית, ולכן שמות המסכים והכפתורים מופיעים בדוח באנגלית.

- התחברות. מוקלדת סיסמה. אחרי 3 ניסיונות שגויים הכפתור ננעל ל-s 30 והמסך מראה כמה זמן נשאר. אם המערכת דרוכה, מופעלת גם אזעקה.
- מסך ראשי. חיווי גדול של מצב המערכת, ספירה לאחור בזמן כניסה, מצב כל חיישן ומצב החיבור של הבקרים. חיישן שהבקר שלו לא מחובר מסומן CONNECTED NOT. כשהמערכת מנוטרלת יש שני כפתורי דריכה: HOME ARM( חיישן הדלת בלבד, אפשר לנוע בתוך הבית( ו-AWAY ARM( כל החיישנים(. כשהמערכת דרוכה או באזעקה הכפתור הוא DISARM. מתחת מוצגות הפעולות האחרונות.
- יומן אירועים. כל האירועים, מהחדש לישן, עם סינון לפי חומרה: קריטי, אזהרה ומידע.
- מצלמה. וידאו חי מהמצלמה, ורשימה של מי שזוהה. אם הווידאו לא מגיע במשך כמה שניות, האפליקציה מציגה תמונה שמתרעננת, כדי שהמסך לא יישאר ריק.

- פנים. רשימת הפנים המאושרות, והוספה של פנים חדשות באמצעות שם ותמונה מהמצלמה.
- הגדרות. מצב לילה ושעותיו, נמעני האימייל, צירוף סרטון לאימייל ואורכו, שינוי הסיסמה והקוד, וכתובת הבקנד.

אם הבקנד לא נגיש, האפליקציה אומרת זאת במפורש: המסך הראשי מעומעם עם הודעה, ופקודה שנכשלה מציגה הודעת שגיאה. בלי זה, לחיצה על DISARM שלא הגיעה לבקנד הייתה נראית כמו נטרול שהצליח.

הטלפון מתחבר לבקנד לפי כתובת ה-IP של המחשב ברשת הביתית, והכתובת נקבעת במסך ההגדרות. הבקנד מגיש גם גרסת web של האפליקציה, שנפתחת בדפדפן באותה כתובת.

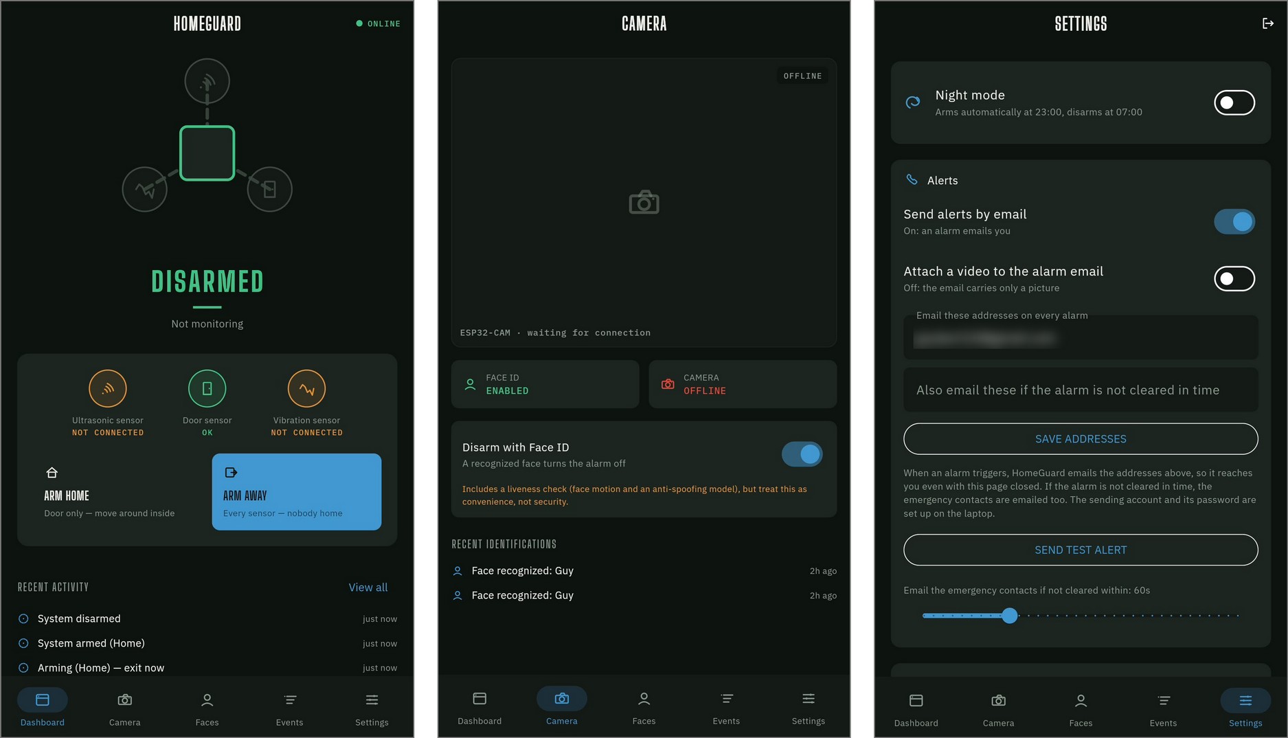
[picture p20: figure]

איור :6 המסך הראשי, המצלמה וההגדרות בגרסת ה-web. בזמן הצילום בקר החיישנים והמצלמה לא היו מחוברים לבקנד

### 4.7 זיהוי פנים

פנים נרשמות מהאפליקציה: מסך הפנים מצלם תמונה מהמצלמה ושומר אותה עם שם. ה-CAM32-ESP שולח תמונה לבקנד כמה פעמים בשנייה. הבקנד מוצא פנים בתמונה, ממיר אותן לווקטור ומשווה לווקטורים של הפנים השמורות. אם הדמיון גבוה מסף, הפנים מזוהות והאירוע נרשם ביומן, פעם ב-s 60 לכל היותר לאותו אדם, כדי שהיומן לא יתמלא.

זיהוי הפנים כולל בדיקת חיות )liveness), כדי להקשות על נטרול בתמונה או בסרטון: נבדקת תנועה של נקודות הפנים לאורך חלון קצר, ומודל נוסף נגד זיוף בודק את התמונה, ושתי הבדיקות חייבות להסכים. גם כך הבדיקה לא מונעת הקרנה חוזרת של סרטון טוב.

אם נטרול בפנים מופעל והמערכת דרוכה, פנים מזוהות מנטרלות אותה, והנטרול נרשם ביומן עם השם. האפשרות כבויה כברירת מחדל ונועדה לנוחות ולא לאבטחה.

### 4.8 התראות ודריכה אוטומטית

אימייל באזעקה. כשמתחילה אזעקה הבקנד שולח אימייל לכל הנמענים שהוגדרו באפליקציה, עם תמונה אחרונה מהמצלמה )איור 5(, ובנוסף סרטון אם צירוף הסרטון מופעל )ברירת המחדל(. האימייל נשלח מחשבון Gmail דרך SMTP. הפרטים של החשבון נשמרים בקובץ מקומי בבקנד ולא באפליקציה. שליחת האימייל רצה ברקע, כך שאם השרת של המייל איטי, האזעקה עצמה לא מתעכבת.

סרטון באימייל. כשכתובת הווידאו של המצלמה מוגדרת, הבקנד צופה בה כל הזמן, כמו עוד צופה בזרם, ושומר בזיכרון את הדקה האחרונה של הפריימים. כשמתחילה אזעקה נלקחים הפריימים של השניות האחרונות, בין 5 ל-s 60 לפי ההגדרה באפליקציה )to video a Attach email alarm the), והם מקודדים לקובץ 4MP בתהליך נפרד, כדי שהקידוד לא יעכב את האזעקה. גודל הסרטון מוגבל ל-MB ,10 כי Gmail מקבל עד MB 25 להודעה והקידוד לטקסט מגדיל את הקובץ בכשליש. אם הסרטון גדול מדי הבקנד יוצר סרטון קל יותר, ואם הסרטון לא נוצר האימייל נשלח עם התמונה בלבד. כשזרם הווידאו לא זמין נשמרות במקומו התמונות שהמצלמה שולחת לזיהוי פנים, אחת עד שתיים בשנייה, והסרטון מורכב מהן. כשהצירוף כבוי הבקנד לא צופה במצלמה, והאימייל נשלח עם תמונה בלבד.

הסלמה. אם האזעקה לא נוקתה תוך זמן שמוגדר באפליקציה )s 60 כברירת מחדל(, נשלח אימייל נוסף, לנמענים הרגילים וגם לאנשי הקשר לחירום. נטרול האזעקה מבטל את ההסלמה. הרשימה של אנשי הקשר נפרדת מרשימת הנמענים הרגילה. חיוג אוטומטי לגורם חירום דורש ספק טלפוניה, ולכן במקומו נשלחת התראה דחופה שאומרת למי להתקשר.

מתג ראשי. בהגדרות יש מתג שמכבה את כל ההודעות היוצאות. האזעקה והסירנה לא מושפעות ממנו.

מצב לילה. מצב לילה דורך את המערכת אוטומטית בשעה קבועה ומנטרל בשעה קבועה אחרת. המצב כבוי כברירת מחדל, ומפעילים אותו באפליקציה. ברירת המחדל לשעות היא דריכה ב23:00- ונטרול ב,07:00- וניתן לשנות אותן. הדריכה היא במצב Home. כמה כללים נקבעו כדי שהתכונה לא תזיק:

- המערכת דורכת רק אם היא מנוטרלת, ומנטרלת רק אם היא דרוכה. אזעקה פעילה לא מושתקת בגלל שהגיעה שעת הנטרול. רק אדם מחליט שהאירוע נגמר.
- הבדיקה רצה רק בשעה העגולה. מי שנטרל ידנית ב23:30- לא יראה את המערכת נדרכת שוב דקה אחר כך.

### 4.9 אבטחה

הכניסה לאפליקציה דורשת סיסמה, והיא אותו קוד כמו בקודן. אחרי 3 ניסיונות שגויים ההתחברות ננעלת ל-s ,30 ואם המערכת דרוכה מופעלת גם אזעקה, כי ניחוש סיסמה עלול להעיד על ניסיון פריצה. הבקרים מזדהים מול הבקנד במפתח משותף. הקוד הוא 4 עד 8 ספרות, והוא נשמר בקובץ הבקנד בטקסט גלוי לצד הגיבוב, ולכן מי שיש לו גישה לקובץ יכול לקרוא אותו. הקודן הפיזי לא מגביל מספר ניסיונות. התקשורת בין הטלפון, הבקרים והבקנד אינה מוצפנת: הכול עובר ב-HTTP רגיל ברשת ה-WiFi הביתית. רק שליחת האימייל לשרת
.)TLS( | מוצפנת | Gmail

כדי להתחבר מהטלפון מספיק להיות באותה רשת ולדעת את כתובת ה-IP של המחשב. המערכת לא נחשפה לאינטרנט. מי שנמצא באותה רשת יכול לנסות לנחש את הקוד או להאזין לתעבורה, ולכן המערכת מתאימה לשימוש ביתי ולא להגנה אמיתית.

### 4.10 זמנים וערכים עיקריים

רוב ההתנהגות של המערכת נקבעת על ידי כמה ערכי זמן. טבלה 3 מרכזת את העיקריים שבהם, כפי שהם מוגדרים בקוד.

טבלה :3 ערכי זמן וסף עיקריים

| | פרמטר ערך איפה
| | ספירת כניסה, עד אזעקה s 30 בקר הדלת
| | ספירת דריכה מהאפליקציה )Away בלבד( s 3 בקר הדלת
| | תחילת צפצופי הספירה, אחרי שקט s 2 בקר הדלת
| | מרווח מינימלי בין שתי לחיצות על הקודן ms 200 בקר הדלת
| | אורך הקוד 4 עד 8 ספרות בקר הדלת
| | קצב דגימת חיישן המרחק כ-Hz 15 בקר החיישנים
| | סטייה מהמרחק הרגיל שנחשבת חריגה יותר מ-cm 10 בקר החיישנים
| | קריאות חריגות ברצף עד דיווח 5 בקר החיישנים
| | הפסקה בין שני דיווחי חדירה או מכה s 5 בקר החיישנים
בקר החיישנים ובקר הדלת | | דיווח חיים כל s 10
| | בקר נחשב לא מחובר אחרי שקט של s 30 בקנד
| | הפסקה בין תמונות מהמצלמה לזיהוי פנים כ-ms 300 בקר המצלמה
בקנד | פעם ב-s 60 לכל היותר | רישום מחדש של אותו אדם ביומן
| | נעילת התחברות אחרי 3 סיסמאות שגויות s 30 בקנד

| | פרמטר ערך איפה
| | תוקף התחברות לאפליקציה h 12 בקנד
| | זמן עד אימייל הסלמה )ברירת מחדל( s 60 בקנד
בקנד | s ,60 אפשר לשנות מ-5 עד s 60 | אורך הסרטון באימייל )ברירת מחדל(
| | גודל מרבי של הסרטון באימייל MB 10 בקנד
בקנד | דריכה ב,23:00- נטרול ב07:00- | שעות מצב לילה )המצב עצמו כבוי כברירת מחדל(

### 4.11 כלים ותוכנות

הכלים והתוכנות שבהם נעשה שימוש מפורטים בטבלה .4

טבלה :4 כלים

| תחום כלי
++C שפת ,Arduino IDE | קושחה
Python, FastAPI | בקנד
| זיהוי פנים OpenCV( YuNet ו-SFace)
HTTP, WebSocket, SMTP | תקשורת
| אפליקציה (Dart (Flutter, לטלפון Android ולדפדפן
| קידוד סרטון FFmpeg( דרך ffmpeg-imageio )ו-OpenCV
| מודל תלת-ממדי סקריפט (numpy (Python שמפיק קבצי STL
| פיתוח האפליקציה האפליקציה פותחה בשיתוף עם (Anthropic (Claude
Mermaid, ליצירת תרשימי הזרימה והמצבים )איורים ,1 2 ו-)4 | תרשימים
| בדיקות pytest
| ניהול קוד Git ו-GitHub

## .5 בדיקות ותוצאות

### 5.1 איך נבדקה המערכת

הבדיקה נעשתה בשתי דרכים.

בדיקות אוטומטיות לבקנד. לבקנד יש בדיקות )[13] pytest )שבודקות את הלוגיקה: מצבי האזעקה, ההתחברות והנעילה, וההתראות. הבדיקות מדמות את הבקרים ואת האפליקציה בבקשות לבקנד, בלי חומרה, ולכן הן רצות מהר וחוזרות על עצמן בכל שינוי בקוד. בדיקות כאלה תופסות טעויות לוגיות, למשל אזעקה שמופעלת בשעה שלא צריך.

בדיקה ידנית על החומרה. שאר המערכת נבדקה על הבקרים עצמם. כל תרחיש מתבצע פיזית: נפתחת הדלת, נעשית חציה מול חיישן המרחק, מוקלד קוד. בכל פעם נבדקות שלוש תוצאות: הצליל שבקר הדלת משמיע, המסך באפליקציה והרשומה ביומן האירועים. את ההדפסות של הבקרים אפשר לראות בזמן הבדיקה ב-Monitor Serial, חלון בסביבת הפיתוח שבו הבקר מדפיס הודעות למחשב, וב-Plotter Serial, שמציג ערכים מספריים כגרף לאורך זמן.

### 5.2 תרחישי הבדיקה

טבלה 5 מפרטת את התרחישים שנבדקו, את התוצאה שנצפתה ואת הסטטוס של כל אחד מהם. תרחישים 1–17 נבדקו על החומרה, ותרחישים 18–22 נבדקו בבדיקות האוטומטיות של הבקנד )סעיף 5.1(.

טבלה :5 תרחישי הבדיקה

| | | # תרחיש תוצאה שנצפתה סטטוס
עבר | נשמע צליל דריכה, והאפליקציה הציגה ARMED | דריכה מהקודן: *, פתיחה וסגירה של הדלת | 1
עבר | הספירה נעצרה, המערכת נוטרלה ונשמע צליל נטרול | פתיחת הדלת במערכת דרוכה והקשת קוד נכון | 2
| | | 3 קוד שגוי בספירת הכניסה נשמע זמזום ארוך, והספירה המשיכה עבר
עבר | הופעלה אזעקה, הוצגה התראה באפליקציה ונשלח אימייל עם תמונה | פתיחת הדלת וחוסר נטרול במשך s 30 | 4
| הופעלה אזעקה עבר | מעבר מול חיישן המרחק במצב Away | 5
| הופעלה אזעקה עבר | דפיקה על חיישן הרעידות במצב Away | 6
| לא הופעלה אזעקה עבר | דפיקה על חיישן הרעידות במצב Home | 7
| לא הופעלה אזעקה עבר | מעבר מול חיישן המרחק במצב Home | 8
| התחילה ספירת כניסה, כמו ב-Away עבר | פתיחת הדלת במצב Home | 9
| נשמע צליל סירוב והאפליקציה הציגה הודעה עבר | דריכה כשהדלת פתוחה, מהקודן ומהאפליקציה | 10
עבר | הפקודה הגיעה לבקר הדלת והצלילים הושמעו | דריכה ונטרול מהאפליקציה | 11
עבר | הווידאו הוצג באפליקציה, ופנים ששמורות במערכת זוהו | | 12 מצלמה חיה וזיהוי פנים
| | | 13 ניתוק בקר מהחשמל האפליקציה הציגה שהבקר לא מחובר עבר

| | | # תרחיש תוצאה שנצפתה סטטוס
עבר | הכפתור ננעל ל-s .30 כשהמערכת דרוכה הופעלה גם אזעקה | שלוש סיסמאות שגויות בהתחברות לאפליקציה | 14
| | | 15 שינוי הקוד מהאפליקציה הקוד החדש עבד בקודן והישן לא עבר
| | | 16 מצב לילה בשעה שהוגדרה המערכת נדרכה במצב Home ונרשם ביומן עבר
עבר | האפליקציה הציגה שאין חיבור, ופקודה שנכשלה הציגה שגיאה | | 17 הבקנד לא נגיש מהטלפון
| נשלח אימייל לאנשי הקשר לחירום עבר | אזעקה שלא נוקתה בזמן שהוגדר | 18
עבר | פנים מאושרות ניטרלו את המערכת כשהייתה דרוכה, בספירת כניסה ובאזעקה. כשהאפשרות כבויה, שהיא ברירת המחדל, לא נוטרלה | נטרול בזיהוי פנים כשהאפשרות מופעלת | 19
עבר | הבקנד הפעיל אזעקה s 5 אחרי שהספירה אמורה להסתיים | בקר הדלת מפסיק לענות באמצע ספירת הכניסה | 20
עבר | הסיסמה, הפנים, ההגדרות ויומן האירועים נשמרו, ומצב הדריכה לא נשמר | | 21 הפעלה מחדש של הבקנד
עבר | האימייל נשלח עם תמונה וסרטון 4MP. כשהסרטון לא נוצר, האימייל נשלח עם התמונה בלבד | אזעקה כשצירוף הסרטון מופעל | 22

הבעיות שהתגלו בבדיקות מפורטות בסעיף .6.2

סרטון הדגמה של המערכת בפעולה: dZWpFDsY9gI/be.youtu://https (https://youtu.be/gI9dZWpFDsY)

### 5.3 תוצאות

איור 7 מראה את קריאות חיישן המרחק ב-Plotter Serial כשאדם עובר מול החיישן. הציר האנכי הוא המרחק ב-cm, והציר האופקי הוא הקריאות לפי הסדר. התצוגה מוחלקת על ידי ה-Plotter Serial. המרחק )dist )יורד מכ-cm ,114 המרחק הרגיל )base), לכ40- עד cm ,50 הרבה מתחת לסף )thr )שנמצא cm 10 מתחת למרחק הרגיל, ונשאר שם לאורך כל החציה. רק כמה קריאות ברצף מתחת לסף גורמות לבקר לשלוח הודעת חדירה )איור 2(. האירועים נרשמים ביומן האפליקציה לפי הסדר, עם שעה. איור 8 מראה התחברות, דריכה במצב Home, נטרול, וגם ניתוק וחיבור של בקר הדלת.

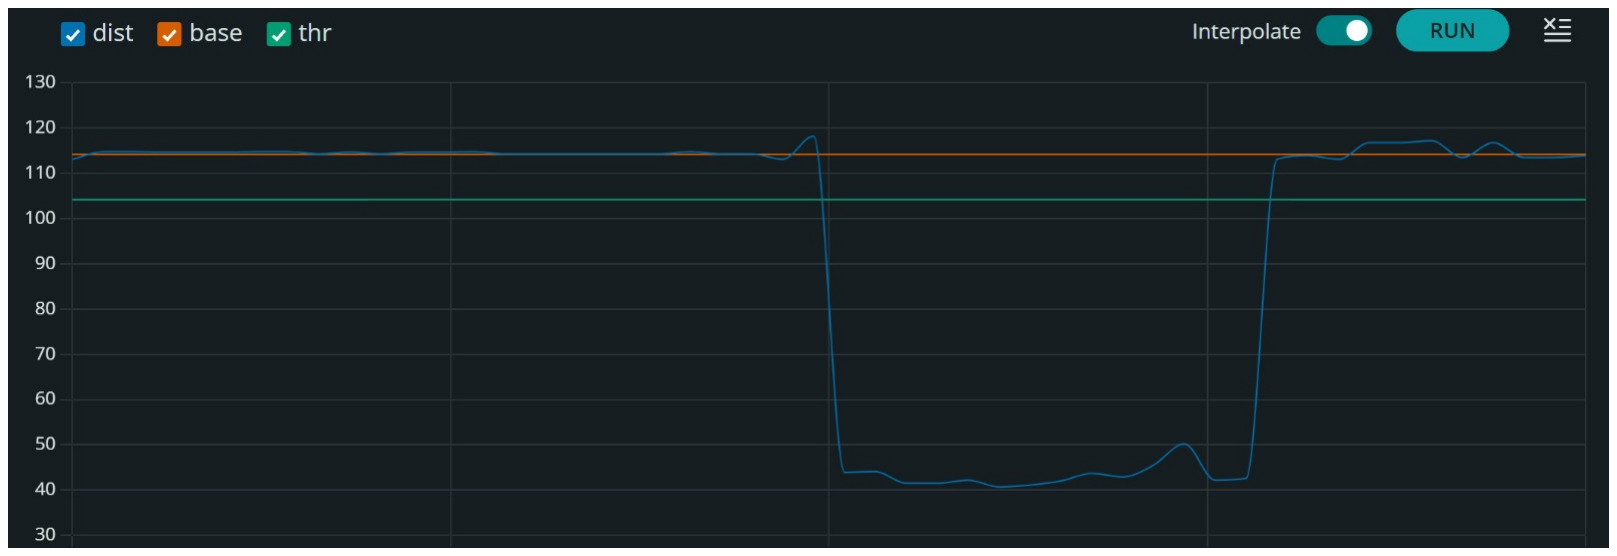
[picture p21: figure]

איור :7 קריאות חיישן המרחק בזמן חציה ב-Plotter Serial: המרחק )dist), המרחק הרגיל )base )והסף )thr)

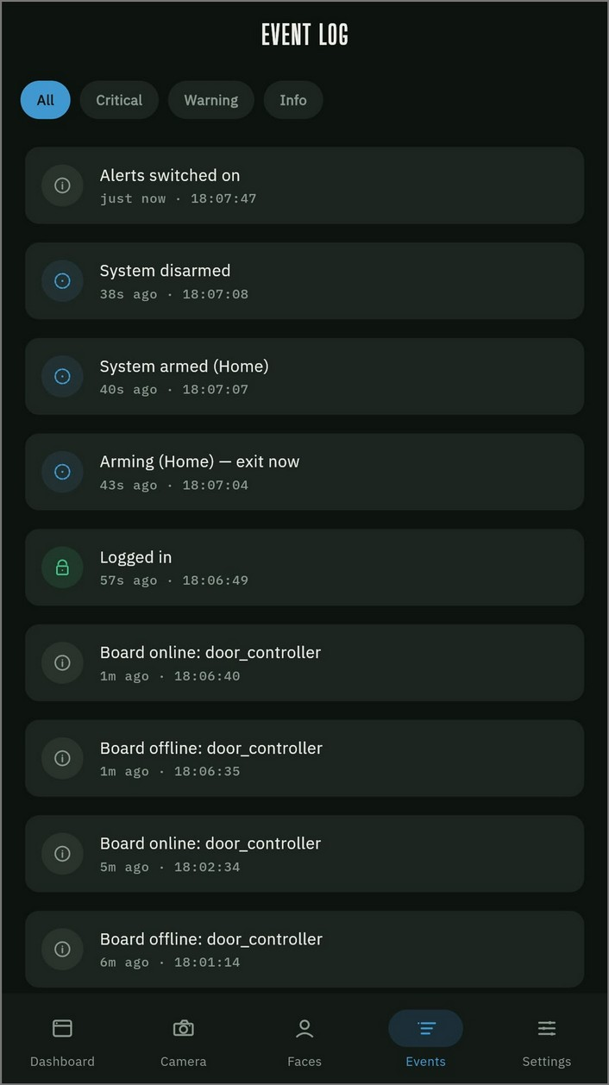
[picture p22: figure]

איור :8 יומן האירועים באפליקציה

### 5.4 ניתוח ומגבלות

- המרחק הרגיל נמדד בכל הפעלה. לכן אין צורך לכוונן את חיישן המרחק ידנית כשמזיזים אותו. החיסרון: אם מישהו עומד מול החיישן בזמן ההפעלה, המרחק הרגיל נמדד לא נכון, והחיישן כמעט לא יזהה אחרי זה את המסדרון הריק. כדי להקטין את הסיכון הבקר פוסל מרחק רגיל שקצר מ-m 1 או ארוך מ-m ,4 וחוזר למרחק האחרון ששמר. הוא גם מציין תקלה בדיווח החיים אם המרחק הרגיל זז ביותר מ-cm 40 מההפעלה הקודמת, או אם החיישן לא מחזיר הד במשך s .30 כרגע הבקנד לא מציג

את התקלה הזאת באפליקציה, והיא נראית רק ביומן הבקשות של הבקנד. זה שיפור שנשאר להמשך.

- חיישן המרחק מכסה כיוון אחד. הקרן של ה04-SR-HC צרה, ולכן החיישן מזהה רק מי שעובר מולו. כיסוי של פתח רחב או של כמה כיוונים דורש יותר חיישנים.
- בקרי החיישנים תלויים בבקנד. בלי המחשב אין התראה מחיישן המרחק ומחיישן הרעידות. בקר הדלת מפעיל סירנה גם בלי הבקנד כשהדלת נפתחת ולא מנטרלים בזמן.
- האימייל דורש אינטרנט. כשאין חיבור לאינטרנט אין אימייל, אבל הסירנה והאפליקציה ברשת הביתית ממשיכות לעבוד.
- הסרטון באימייל תלוי במצלמה. כשזרם הווידאו של המצלמה לא זמין, הסרטון מורכב מהתמונות שהיא שולחת לזיהוי פנים והוא פחות חלק. הפריימים נשמרים בזיכרון בלבד, ולכן אחרי הפעלה מחדש של הבקנד הסרטון מתחיל ריק.
- כתובת ה-IP של המחשב משתנה. ברשת הביתית כתובת המחשב עלולה להשתנות. בקר שנצרב עם כתובת ישנה לא מגיע לבקנד, ונראה כמו תקלת חומרה. הבקנד בודק בהפעלה אם הבקרים מכוונים לכתובת הנוכחית ומזהיר, אבל תיקון עדיין דורש צריבה מחדש של הבקר. רק בקר החיישנים מחפש את הבקנד בעצמו, ורק כשהוא מחובר ל-hotspot של טלפון: הוא בודק את טווח הכתובות של ה-hotspot.
- הסירנה יושבת על בקר הדלת. אם בקר הדלת מנותק, אזעקה שהתחילה בחיישן אחר תוצג באפליקציה ותישלח באימייל, אבל לא תושמע סירנה.
- הבקנד לא זוכר אם המערכת דרוכה. אחרי הפעלה מחדש הוא מתחיל במצב מנוטרל ומתעדכן כשבקר הדלת מדווח. כך האפליקציה לא מציגה מצב ישן שאף אחד לא אימת.

## .6 סיכום ומסקנות

### 6.1 עמידה במטרות

טבלה 6 משווה בין מטרות ההצעה לבין מה שהושלם.

טבלה :6 מטרות הפרויקט

| מטרה מצב
הושלם | זיהוי חדירה )חיישן מרחק או דלת( וניסיון פריצה בכוח
| נטרול באמצעות קודן פיזי הושלם
| אזעקה קולית הושלם
| שמירת פנים מאושרות וזיהוי שלהן במצלמה הושלם
לא הושלם. במקומה פנים מאושרות מנטרלות את המערכת, באופט-אין | הפעלת אזעקה בזיהוי פנים לא מאושרות
| יומן אירועים בזמן אמת בטלפון הושלם
| שינוי הקוד מהאפליקציה הושלם
הושלם | אימייל עם תמונה וסרטון, וידאו חי ודריכה אוטומטית בשעות הלילה )מעבר להצעה(
הושלם חלקית. באפליקציה, 3 סיסמאות שגויות כשהמערכת דרוכה מפעילות אזעקה ונועלות את ההתחברות ל-s .30 בקודן הפיזי קוד שגוי משמיע זמזום ארוך בלבד | אזעקה אוטומטית אחרי 3 קודים שגויים

### 6.2 אתגרים ופתרונות

רוב הקשיים התגלו רק כשהקוד רץ על הבקרים. חמישה מהם מתוארים כאן.

הזמזמים נדלקו שוב אחרי קוד נכון. בספירת הכניסה, אחרי שהוקש קוד נכון, הסירנה והצפצופים נעצרו ומיד נדלקו מחדש. הסיבה הייתה פקודה חסרה בקוד: בענף שמטפל בנטרול לא היה break, והביצוע המשיך באותה ריצה של הלולאה אל החלק שמפעיל את הצפצופים. התיקון היה הוספת הפקודה החסרה. תקלה כזאת לא נראית בבדיקות על המחשב, כי היא תלויה בלולאה שרצה על הבקר.

בקר הדלת לא ענה בזמן שדיווח לבקנד. הלולאה הראשית של בקר הדלת שלחה דיווחים לבקנד ברצף, ובקשה אחת יכלה לחסום אותה עד s .10 בזמן הזה הבקר לא ענה לפקודות מהבקנד )דריכה, נטרול והפעלת סירנה( ופספס לחיצות על הקודן. התיקון נעשה בשני שלבים: מגבלת זמן של s 1 לכל בקשה, ואחר כך העברת הדיווח לתור ולמשימה נפרדת שרצה ברקע.

חיישן המרחק יכול לפספס חדירה. בגרסה הראשונה הסף היה רחב: סטייה של cm 30 ו8-קריאות ברצף. חדירה בעצם קטן או במרחק גבולי יכלה לעבור בלי זיהוי. הסף הוחמר ל10-cm ול5- קריאות, והמרחק הרגיל נמדד מחדש בכל הפעלה ולא נקבע מראש. כדי שמדידה בזמן שמישהו עומד מול החיישן לא תקבע מרחק שגוי, נוספו גבולות סבירות )בין m 1 ל-m 4 )ושמירה של המרחק האחרון התקין.

כתובת ה-IP של המחשב משתנה. ברשת עם DHCP כתובת המחשב מתחלפת מדי פעם, ובקר שנצרב עם כתובת ישנה לא מגיע לבקנד. הוא נראה כמו תקלת חומרה, והבעיה חזרה כמה פעמים. בהפעלה הבקנד משווה עכשיו את הכתובת הנוכחית לכתובת שצרובה בכל בקר ומזהיר ביומן אם יש אי-התאמה. התיקון עצמו עדיין דורש צריבה מחדש של הבקר, חוץ מבקר החיישנים ב-hotspot של טלפון, שמחפש את הבקנד בעצמו.

צריבת ה-CAM32-ESP. ללוח המצלמה אין איפוס אוטומטי לצריבה, ולכן כל צריבה דורשת רצף ידני: להחזיק את BOOT, ללחוץ ולשחרר RESET, לשחרר את BOOT ולהתחיל מיד את ההעלאה. אחרי ההעלאה לוחצים RESET כדי שהקוד החדש ירוץ. בלי הרצף ההעלאה נכשלת ."Failed to connect to ESP32" בשגיאה

### 6.3 מסקנות

- ההפרדה בין בקרים קטנים לבקנד עובדת טוב. שינוי התנהגות, כמו מצב Home, נעשה בבקנד בלי לצרוב את הבקרים מחדש.
- רוב הבעיות התגלו רק על החומרה, ולא בבדיקות על המחשב. כך היה עם הזמזמים שנדלקו שוב אחרי קוד נכון, ועם בקר הדלת שלא הגיב לפקודות בזמן שדיווח לבקנד )סעיף 6.2(. בדיקות אוטומטיות לא מחליפות בדיקה פיזית.
- צלילים קצרים וברורים לכל פעולה בקודן עושים את השימוש בו הרבה יותר נוח.
- חיישן שנכשל בשקט מסוכן יותר מחיישן שנכשל בקול. למשל, מרחק רגיל שנמדד לא נכון גורם לחיישן להפסיק לזהות בלי שום סימן חיצוני. לכן בקרי החיישנים מוסיפים בדיקות שפיות ומדווחים תקלה לבקנד, אף שהיא עדיין לא מוצגת באפליקציה.
- בחיבור של כמה רכיבים מתחומים שונים, החלק הקשה הוא לא הרכיבים עצמם אלא החיבור ביניהם: זמנים, סדר פעולות ומצבים שהמערכת צריכה להסכים עליהם.

### 6.4 המשך

- הצפנת התקשורת )HTTPS )ומפתח נפרד לכל בקר.
- הפעלת אזעקה אחרי 3 קודים שגויים בקודן.
- הצגת תקלות חיישנים באפליקציה, למשל חיישן מרחק שמכוון לחלל פתוח או שהוזז.

- כתובת קבועה למחשב ברשת הביתית, כדי שהבקרים לא יאבדו אותו.
- התראות Push לטלפון, והודעת SMS או חיוג.
- סוללת גיבוי למקרה של הפסקת חשמל.
- חיישנים נוספים, למשל עשן ושבירת זכוכית.
- שיפור הדיוק של זיהוי הפנים.

## .7 רשימת מקורות

[1] Espressif Systems, "ESP32 Series Datasheet," Espressif Systems, Shanghai, China. [Online]. Available: https://www.espressif.com/sites/default/files/documentation/esp32_datasheet_e n.pdf. Accessed: Oct. 17, 2026.
[2] Espressif Systems, "Arduino-ESP32 Documentation." [Online]. Available: https://docs.espressif.com/projects/arduino-esp32/en/latest/. Accessed: Oct. 17, 2026.
[3] Elec Freaks, "Ultrasonic Ranging Module HC-SR04," datasheet. [Online]. Available: https://cdn.sparkfun.com/datasheets/Sensors/Proximity/HCSR04.pdf. Accessed: Oct. 17, 2026.
[4] Texas Instruments, "LM393 Dual Differential Comparator," product page. [Online]. Available: https://www.ti.com/product/LM393. Accessed: Oct. 17, 2026.
[5] Arduino Playground, "Keypad Library." [Online]. Available: https://playground.arduino.cc/Code/Keypad/. Accessed: Oct. 17, 2026.
[6] W. Wu, H. Peng, and S. Yu, "YuNet: A tiny millisecond-level face detector," Mach. Intell. Res., vol. 20, no. 5, pp. 656–665, 2023, doi: 10.1007/s11633-023-1423-y.
[7] Y. Zhong, W. Deng, J. Hu, D. Zhao, X. Li, and D. Wen, "SFace: Sigmoid-constrained hypersphere loss for robust face recognition," IEEE Trans. Image Process., vol. 30, pp. 2587–2598, 2021, doi: 10.1109/TIP.2020.3048632.
[8] OpenCV, "opencv-contrib-python," Python Package Index (PyPI). [Online]. Available: https://pypi.org/project/opencv-contrib-python/. Accessed: Oct. 17, 2026.
[9] S. Ramírez, "FastAPI Documentation." [Online]. Available: https://fastapi.tiangolo.com/. Accessed: Oct. 17, 2026.
[10] I. Fette and A. Melnikov, "The WebSocket Protocol," IETF, RFC 6455, Dec. 2011. [Online]. Available: https://www.rfc-editor.org/rfc/rfc6455. Accessed: Oct. 17, 2026.

[11] Python Software Foundation, "smtplib — SMTP protocol client," Python 3 Documentation. [Online]. Available: https://docs.python.org/3/library/smtplib.html. Accessed: Oct. 17, 2026.
[12] Google, "Flutter Documentation." [Online]. Available: https://docs.flutter.dev/. Accessed: Oct. 17, 2026.
[13] pytest-dev, "pytest Documentation." [Online]. Available: https://docs.pytest.org/. Accessed: Oct. 17, 2026.

## .8 נספחים

### 8.1 רשימת חומרים )BOM)

הרכיבים שבהם נבנתה המערכת מפורטים בטבלה .7

טבלה :7 רשימת חומרים

| | שם הרכיב תיאור כמות מחיר )₪(
| | לוח פיתוח 32ESP( C340CH, סט( בקר עם WiFi 1 20.67
| בקר עם WiFi 1 6.17 | ( ESP32 DEVKIT V1 פיתוח לוח 30 ,C-USB פינים(
| בקר עם מצלמה 1 53.07 | ערכת CAM32-ESP עם מודול מצלמה
1 28.92 | מודד מרחק בעזרת צליל | חיישן מרחק 04SR-HC
| | חיישן רעידות -420SW מזהה מכה או רעידה 1 3.04
1 3.04 | מזהה אם הדלת נפתחה | חיישן דלת מגנטי -38MC
| | קודן מטריצה 3×4 מקלדת להקשת קוד 1 7.72
2 12.42 | משמיע את הצלילים והסירנה | זמזם
1 10.44 | חיבור הרכיבים בלי הלחמה | לוח ניסוי 400 נקודות
| | חוטי גישור, 40 יחידות חיבור הרכיבים 1 20.06
1 6.83 | חיבור לחשמל ולמחשב | כבל m 1 ,USB Micro
| | סה"כ 172.38

### 8.2 הוראות הפעלה קצרות

טבלה 8 מסבירה צעד אחר צעד איך דורכים, נכנסים ומנטרלים, בקודן שליד הדלת ובאפליקציה. טבלה 9 מסבירה פעולות שנעשות באפליקציה בלבד. שמות הכפתורים והמסכים מופיעים כפי שהם באפליקציה.

טבלה :8 דריכה, כניסה ונטרול

| | פעולה בקודן באפליקציה
בלשונית Dashboard לוחצים ARM AWAY( כל החיישנים פעילים( או HOME ARM( רק חיישן הדלת פעיל, ואפשר לנוע בבית(. הדלת חייבת להיות סגורה. המסך מציג ARMING כ-s 3 ואחר כך ARMED. | .1 מוודאים שהדלת סגורה. .2 לוחצים *. .3 פותחים את הדלת, יוצאים וסוגרים אותה. ברגע שהדלת נסגרה המערכת נדרכת ונשמע צליל דריכה )שני צפצופים קצרים וצפצוף ארוך(. הדריכה בקודן היא במצב Away, או במצב האחרון שנבחר באפליקציה. | דריכה
לוחצים DISARM בזמן שהמסך מציג ARMING. | לוחצים * שוב לפני שהדלת נסגרה. המערכת חוזרת למצב מנוטרל ונשמע צליל נטרול. | ביטול דריכה באמצע
המסך הראשי מציג NOW DISARM וספירה לאחור. אפשר ללחוץ DISARM במקום להקיש קוד. | .1 פותחים את הדלת. מתחילה ספירה של s ,30 ואחרי s 2 בלי הקשה נשמעים צפצופים שהולכים ומתמהרים. .2 מקישים את הקוד ואחריו .# הצפצופים נפסקים בזמן ההקלדה. קוד נכון מנטרל את המערכת. קוד שגוי משמיע זמזום ארוך והספירה ממשיכה. אם הספירה נגמרת, האזעקה מופעלת. | כניסה כשהמערכת דרוכה
לוחצים DISARM. | מקישים את הקוד )4 עד 8 ספרות( ואחריו .# הסירנה נפסקת ונשמע צליל נטרול. | נטרול כשהאזעקה פועלת

טבלה :9 פעולות באפליקציה

| פעולה איפה ומה עושים
בלשונית Settings, באזור PIN keypad & Password, מקלידים את הסיסמה הנוכחית ואת הקוד החדש פעמיים )ספרות בלבד, 4 עד 8( ולוחצים PIN & PASSWORD UPDATE. הקוד החדש משמש גם בקודן וגם להתחברות לאפליקציה. | שינוי הקוד
בלשונית Settings, באזור Alerts: הרשימה הראשונה היא הכתובות שיקבלו אימייל בכל אזעקה, והשנייה הכתובות שיקבלו אימייל אם האזעקה לא נוקתה בזמן. לוחצים ADDRESSES SAVE. הכפתור ALERT TEST SEND שולח הודעת בדיקה אמיתית. המתג alerts Send email by מכבה את כל ההודעות היוצאות. | שינוי נמעני האימייל

| פעולה איפה ומה עושים
בלשונית Settings, באזור Alerts, מפעילים או מכבים את a Attach email alarm the to video. כשהמתג פועל, מחוון קובע כמה שניות מהמצלמה יצורפו )5 עד 60(. ברירת המחדל היא 60 שניות. | צירוף סרטון לאימייל
בלשונית Faces מוסיפים פנים חדשות וכותבים שם. האדם צריך לעמוד מול המצלמה באותו רגע, כי האפליקציה שומרת את התמונה האחרונה מהמצלמה. אם לא נראות פנים בתמונה, מוצגת הודעה ויש לנסות שוב. | הוספת פנים
Disarm with Face את מפעילים ,FACE ID בכרטיס ,Camera בלשונית ID. האפשרות כבויה כברירת מחדל. פנים מוכרות מנטרלות את המערכת. האפשרות נועדה לנוחות ולא לאבטחה. | נטרול בזיהוי פנים
בלשונית Settings, באזור mode Night, מפעילים את המתג ובוחרים שעת דריכה )at Arms )ושעת נטרול )at Disarms). ברירת המחדל היא 23:00 ו.07:00- המערכת נדרכת במצב Home בשעה העגולה ומנוטרלת בבוקר. אזעקה פעילה לא מושתקת. | דריכה אוטומטית בלילה
הלשונית Camera מציגה וידאו חי ומי שזוהה. הלשונית Events מציגה את כל האירועים, עם סינון לפי חומרה: Warning ,Critical ,All ו-Info. | מצלמה ויומן אירועים

הערות לטבלאות:

- הלחצן * מתחיל דריכה ומבטל אותה, והלחצן # מאשר את הקוד שהוקש.
- בקודן, הקוד פועל רק אחרי שהדלת נפתחה )בספירת הכניסה( או כשהאזעקה כבר פועלת. כשהמערכת דרוכה והדלת סגורה, מנטרלים מהאפליקציה.
- במצב Away כל החיישנים פעילים. במצב Home חיישן המרחק וחיישן הרעידות מוחרגים, וחיישן הדלת ממשיך לעבוד.

הקוד המלא והקבצים הנלווים מצורפים בקובץ ה-ZIP של הגשת הפרויקט.
