yairbon/HomeGuard/docs/enclosure/tray.stl

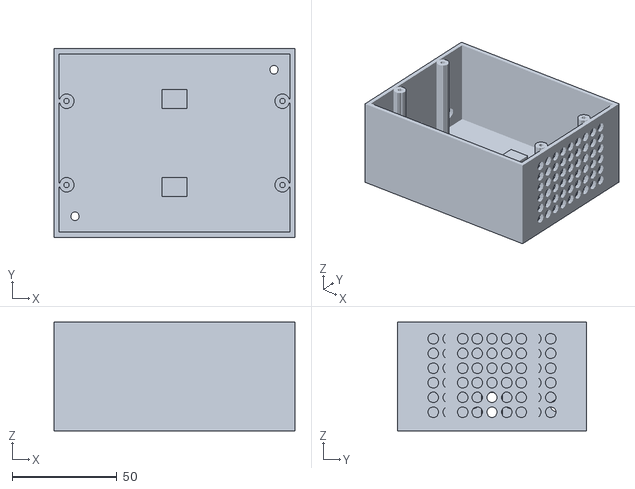
[picture p23: CAD file, 2026-10-21]
docs/enclosure/tray.stl
115.0 x 90.0 x 52.0
