yairbon/HomeGuard/docs/enclosure/tray_snap.stl

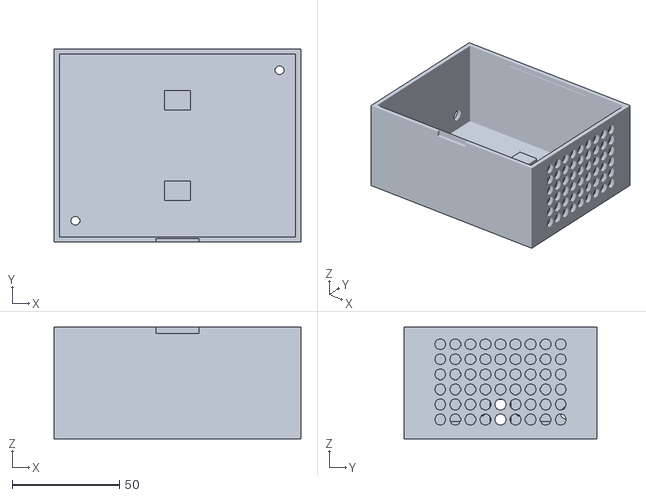
[picture p24: CAD file, 2026-10-21]
docs/enclosure/tray_snap.stl
115.0 x 90.0 x 52.0
