yairbon/HomeGuard/report/TODO_before_submission.md

# רשימת השלמות לפני ההגשה

נוצר אוטומטית מקובץ ה-Word (`python report/tools/list_placeholders.py`). בכל סעיף: הסעיף בדוח, הכיתוב/הטבלה הרלוונטיים, והנוסח של הסימון שיש להחליף. בקובץ ה-Word כל סימון כזה מודגש בצהוב (חיפוש: `[הכנס`, `[להשלים`, `[לאמת`, `[הוסף קישור`).
