yairbon/HomeGuard/esp32/esp32_cam/esp32_cam.ino

// ==========================================
// HomeGuard - Camera worker (board 4 of 4: ESP32-CAM)
// ==========================================
//
// This board replaces this project's original assumption that the camera
// would be a USB webcam on the PC running python/camera_worker.py — this
// one had actually been sitting pre-flashed with the stock Arduino
// "CameraWebServer" example (its own little web page, on whatever WiFi
// network someone last configured it for). That's a fine way to eyeball
// the lens, but it's a dead end for this project: nothing here would ever
// pull frames from it, the same way nothing ever called /camera/recognize
// before camera_worker.py existed (see that file's own comment).
//
// So instead of *serving* a page, this board mirrors what camera_worker.py
// already does from a PC: capture a frame and POST it straight to the
// backend's /camera/recognize, authenticated with the shared device key.
// That endpoint doesn't care whether the sender is a PC with a USB webcam
// or a board like this one — same multipart upload either way — so this
// needed zero backend or app changes, only a new frame source.
//
// Pin numbers below are the standard AI-Thinker ESP32-CAM module wiring
// (this is the common, widely-sold variant — confirmed the right one here
// because it's the same layout the pre-existing CameraWebServer firmware
// was built for, and that firmware worked). A different ESP32-CAM board
// would need different pins.

#include "esp_camera.h"
#include "esp_http_server.h"
#include "soc/soc.h"
#include "soc/rtc_cntl_reg.h"
#include <WiFi.h>
#include <HTTPClient.h>
#include "esp_system.h"  // esp_restart(), for the two unrecoverable paths below
#include "esp_wifi.h"    // esp_wifi_set_ps(): WiFi power-save off, see connectWiFi()
#include "esp_heap_caps.h"
#include "lwip/sockets.h"  // setsockopt(TCP_NODELAY) on the stream socket

// See esp32/secrets.h.example. Copy it into this folder as secrets.h and
// fill in the same values used for the other three boards.
#include "secrets.h"

const char* ssid = WIFI_SSID;
const char* password = WIFI_PASSWORD;
const char* backendHost = BACKEND_HOST;
const int backendPort = BACKEND_PORT;

// --- AI-Thinker ESP32-CAM pin map ---
#define PWDN_GPIO_NUM     32
#define RESET_GPIO_NUM    -1
#define XCLK_GPIO_NUM      0
#define SIOD_GPIO_NUM     26
#define SIOC_GPIO_NUM     27
#define Y9_GPIO_NUM       35
#define Y8_GPIO_NUM       34
#define Y7_GPIO_NUM       39
#define Y6_GPIO_NUM       36
#define Y5_GPIO_NUM       21
#define Y4_GPIO_NUM       19
#define Y3_GPIO_NUM       18
#define Y2_GPIO_NUM        5
#define VSYNC_GPIO_NUM    25
#define HREF_GPIO_NUM     23
#define PCLK_GPIO_NUM     22

// How often a frame is pushed for face recognition (the live view is the
// separate /stream below and does not depend on this). It is the time from the
// START of one push to the start of the next, so a slow reply from the backend
// does not stretch it: about 3 pushes a second, which in practice is ~2 a
// second because each push also waits for the backend's answer. Faster pushes
// make a face disarm quicker; measured, they do not slow the stream. The real
// ceiling is how fast the backend can process a frame (recognition, when
// enabled, is the expensive part).
const unsigned long CAPTURE_INTERVAL_MS = 300;
unsigned long lastCapture = 0;

bool initCamera() {
  camera_config_t config;
  config.ledc_channel = LEDC_CHANNEL_0;
  config.ledc_timer = LEDC_TIMER_0;
  config.pin_d0 = Y2_GPIO_NUM;
  config.pin_d1 = Y3_GPIO_NUM;
  config.pin_d2 = Y4_GPIO_NUM;
  config.pin_d3 = Y5_GPIO_NUM;
  config.pin_d4 = Y6_GPIO_NUM;
  config.pin_d5 = Y7_GPIO_NUM;
  config.pin_d6 = Y8_GPIO_NUM;
  config.pin_d7 = Y9_GPIO_NUM;
  config.pin_xclk = XCLK_GPIO_NUM;
  config.pin_pclk = PCLK_GPIO_NUM;
  config.pin_vsync = VSYNC_GPIO_NUM;
  config.pin_href = HREF_GPIO_NUM;
  config.pin_sscb_sda = SIOD_GPIO_NUM;
  config.pin_sscb_scl = SIOC_GPIO_NUM;
  config.pin_pwdn = PWDN_GPIO_NUM;
  config.pin_reset = RESET_GPIO_NUM;
  config.xclk_freq_hz = 20000000;
  config.pixel_format = PIXFORMAT_JPEG;

  // Smaller/lower-quality without PSRAM because the two frame buffers
  // FRAMESIZE_VGA needs don't fit in the ESP32's plain internal RAM once
  // WiFi + HTTPClient are also using it — this is the same fallback the
  // stock CameraWebServer example uses, kept here for the same reason.
  //
  // grab_mode/fb_location weren't set explicitly before (left as whatever
  // the stack held) — that was harmless for a single timed shot,
  // but now that /stream (startCameraServer, below) and sendFrame() are two
  // independent consumers pulling frames concurrently, it matters:
  // CAMERA_GRAB_LATEST always hands back the newest frame and drops stale
  // ones rather than queuing, so a slow consumer doesn't build up lag over
  // a long-lived stream connection. This needs fb_count>=2 to actually help
  // (two consumers sharing one buffer just serialize on it), which is why
  // the no-PSRAM fallback below is fb_count=1 only — with no PSRAM, running
  // the stream and the recognition push at once will contend for that
  // single buffer and roughly halve both.
  if (psramFound()) {
    config.frame_size = FRAMESIZE_VGA;
    config.jpeg_quality = 12;
    config.fb_count = 2;
    config.fb_location = CAMERA_FB_IN_PSRAM;
    config.grab_mode = CAMERA_GRAB_LATEST;
  } else {
    config.frame_size = FRAMESIZE_CIF;
    config.jpeg_quality = 15;
    config.fb_count = 1;
    config.fb_location = CAMERA_FB_IN_DRAM;
    config.grab_mode = CAMERA_GRAB_LATEST;
  }

  esp_err_t err = esp_camera_init(&config);
  if (err != ESP_OK) {
    Serial.printf("Camera init failed: 0x%x\n", err);
    return false;
  }
  return true;
}

// ---- Frame upload -------------------------------------------------------

// Everything in this block is built once, at boot, instead of per frame. The
// original rebuilt the URL, the boundary, the multipart head and the
// multipart tail on every send — six to eight transient Strings, twice a
// second, forever. Each is a malloc/free pair in internal DRAM (the big body
// buffer itself is fine: it clears the 16KB threshold, so it lands in PSRAM),
// and that steady churn against a small heap is the classic "runs for hours,
// then quietly stops" shape.
//
// The stack-local HTTPClient was worse than merely wasteful: ~HTTPClient()
// calls stop() unconditionally, so the core's default keep-alive (_reuse is
// true) was thrown away and every frame paid a fresh TCP connect and close —
// roughly two connections a second against a 16-socket pool. A file-scope
// client is what actually keeps the socket open: begin() with an unchanged
// host and port reuses the live connection instead of reconnecting, and end()
// leaves it open while _reuse is set. begin() also clears the header list, so
// the two addHeader() calls below don't accumulate across frames.
static const String MULTIPART_BOUNDARY = "HomeGuardCamBoundary";
static const String CAMERA_UPLOAD_URL =
  "http://" + String(backendHost) + ":" + String(backendPort) + "/camera/recognize";
static const String MULTIPART_CONTENT_TYPE = "multipart/form-data; boundary=" + MULTIPART_BOUNDARY;
static const String MULTIPART_HEAD = "--" + MULTIPART_BOUNDARY +
                                     "\r\nContent-Disposition: form-data; name=\"photo\"; filename=\"frame.jpg\""
                                     "\r\nContent-Type: image/jpeg\r\n\r\n";
static const String MULTIPART_TAIL = "\r\n--" + MULTIPART_BOUNDARY + "--\r\n";

HTTPClient cameraHttp;

// Back-off and failure state, both consumed by noteSendResult() below.
unsigned long sendBackoffMs = 0;
const unsigned long BACKOFF_MIN_MS = 500;
const unsigned long BACKOFF_MAX_MS = 30000;
int consecutiveFailures = 0;
const int FAILURE_RESTART_THRESHOLD = 40;

// sendFrame()'s return value for "nothing was sent" — no frame captured, or
// no memory to build the body. Distinct from an HTTP status (>0) and from an
// HTTPClient transport error (<0), because those two mean the backend was
// actually reached, or reached for, and this one doesn't.
const int SEND_LOCAL_FAILURE = 0;

// Builds a minimal multipart/form-data body by hand (ESP32's HTTPClient has
// no multipart helper) and POSTs it to /camera/recognize — the same field
// name ("photo") and shape python/camera_worker.py sends, so the backend
// can't tell the two apart. Returns the HTTP status, a negative HTTPClient
// error, or SEND_LOCAL_FAILURE.
int sendFrame() {
  camera_fb_t* fb = esp_camera_fb_get();
  if (!fb) {
    Serial.println("Frame capture failed");
    return SEND_LOCAL_FAILURE;
  }

  const size_t totalLen = MULTIPART_HEAD.length() + fb->len + MULTIPART_TAIL.length();
  uint8_t* body = (uint8_t*)malloc(totalLen);
  if (!body) {
    Serial.println("Out of memory building the upload body — skipping this frame");
    esp_camera_fb_return(fb);
    return SEND_LOCAL_FAILURE;
  }

  size_t pos = 0;
  memcpy(body + pos, MULTIPART_HEAD.c_str(), MULTIPART_HEAD.length());
  pos += MULTIPART_HEAD.length();
  memcpy(body + pos, fb->buf, fb->len);
  pos += fb->len;
  memcpy(body + pos, MULTIPART_TAIL.c_str(), MULTIPART_TAIL.length());

  // The frame buffer is only needed to fill `body` above — release it before
  // the (slow, blocking) network call so the camera driver can reuse it for
  // the next capture instead of sitting idle for the round trip.
  esp_camera_fb_return(fb);

  cameraHttp.begin(CAMERA_UPLOAD_URL);
  cameraHttp.setReuse(true);
  cameraHttp.addHeader("X-Device-Key", DEVICE_KEY);
  cameraHttp.addHeader("Content-Type", MULTIPART_CONTENT_TYPE);

  int code = cameraHttp.POST(body, totalLen);
  free(body);
  cameraHttp.end();  // keeps the TCP connection open — see setReuse() above

  if (code == 401) {
    Serial.println("Frame REJECTED (401) — DEVICE_KEY in secrets.h doesn't match the backend's.");
  } else if (code < 0) {
    Serial.printf("Error sending frame: %s\n", cameraHttp.errorToString(code).c_str());
  } else if (code < 200 || code >= 300) {
    Serial.printf("Backend refused the frame: HTTP %d\n", code);
  }
  // No success message on every frame — a couple of lines a second would flood
  // the log; a rejection or a connection error is the only thing worth
  // interrupting the console for.

  return code;
}

// Applies the two responses to a frame that didn't land: an exponential
// back-off, and eventually a reboot.
//
// The back-off exists because sendFrame() used to read the response code only
// to print it. A backend answering 401 (mismatched DEVICE_KEY) or 500 got the
// same 15-40KB JPEG re-POSTed twice a second, indefinitely — WiFi airtime
// spent on a request that cannot start succeeding, on the same radio the
// alarm path's own reports have to get through. Only results that reached the
// network back off; a capture failure or an OOM never got there, so there is
// nothing at the other end to be gentle with.
//
// The reboot is for the other failure mode: a fragmented heap or a wedged
// camera driver, where the board keeps running and keeps sending nothing. The
// threshold is deliberately deaf to short backend outages — with the
// back-off, 40 consecutive network failures take about 20 minutes, while 40
// local failures (which don't back off) take 20 seconds. That asymmetry is
// the point: rebooting cannot fix someone else's server, but it does fix us.
void noteSendResult(int result) {
  if (result >= 200 && result < 300) {
    consecutiveFailures = 0;
    sendBackoffMs = 0;
    return;
  }

  consecutiveFailures++;

  if (result != SEND_LOCAL_FAILURE) {
    unsigned long next = (sendBackoffMs == 0) ? BACKOFF_MIN_MS : sendBackoffMs * 2;
    sendBackoffMs = (next > BACKOFF_MAX_MS) ? BACKOFF_MAX_MS : next;
    Serial.printf("Backing off %lums (%d frames in a row failed)\n", sendBackoffMs, consecutiveFailures);
  }

  if (consecutiveFailures >= FAILURE_RESTART_THRESHOLD) {
    Serial.printf("FATAL: %d frames in a row failed — restarting.\n", consecutiveFailures);
    Serial.flush();  // esp_restart() doesn't drain the UART on its way out
    delay(1000);
    esp_restart();
  }
}

// ---- Live stream server (new) ------------------------------------------
//
// Runs via esp_http_server (esp_http_server.h), NOT Arduino's WebServer
// class — that distinction is what makes this coexist with the sendFrame()
// push loop above at all. httpd_start() spins up its own FreeRTOS task
// automatically, so stream_handler's infinite per-client loop runs on a
// task of its own and never touches loop() — unlike Arduino's WebServer,
// where handleClient() (and by extension loop()) would block for the
// entire streaming session inside the handler, starving sendFrame()
// completely while any client is connected.
//
// The backend (python/backend/main.py, /camera/stream) connects here and
// relays the raw multipart bytes through to the app — this board never
// talks to the app directly, same "board is a client the backend fronts"
// shape as the other three boards, just inverted for this one endpoint
// (backend pulls, instead of board pushes).

static const char* STREAM_BOUNDARY = "\r\n--HomeGuardCamBoundary\r\n";
static const char* STREAM_CONTENT_TYPE = "multipart/x-mixed-replace;boundary=HomeGuardCamBoundary";
static const char* STREAM_PART_HEADER = "Content-Type: image/jpeg\r\nContent-Length: %u\r\n\r\n";

httpd_handle_t streamHttpd = NULL;

// Same shared DEVICE_KEY the rest of the fleet uses (secrets.h) — checked
// as an X-Device-Key header first (what the backend's httpx proxy sends,
// matching sendFrame()'s own auth), falling back to a ?key= query param
// (a browser/VLC/img-tag MJPEG viewer generally can't set a custom header
// the way HTTPClient/httpx can).
bool authorized(httpd_req_t* req) {
  char hdr[64];
  if (httpd_req_get_hdr_value_str(req, "X-Device-Key", hdr, sizeof(hdr)) == ESP_OK) {
    return strcmp(hdr, DEVICE_KEY) == 0;
  }
  char query[96], key[64];
  if (httpd_req_get_url_query_str(req, query, sizeof(query)) == ESP_OK &&
      httpd_query_key_value(query, "key", key, sizeof(key)) == ESP_OK) {
    return strcmp(key, DEVICE_KEY) == 0;
  }
  return false;
}

// Room for "boundary + part header + one JPEG" in one piece. A VGA q12 frame is
// 10-40 KB, so this has plenty of margin; a frame that does not fit is sent the
// slow way (three chunks), and so is every frame if there is no PSRAM to hold
// the buffer.
static const size_t STREAM_BUF_BYTES = 96 * 1024;

esp_err_t streamHandler(httpd_req_t* req) {
  if (!authorized(req)) {
    httpd_resp_send_err(req, HTTPD_401_UNAUTHORIZED, NULL);
    return ESP_FAIL;
  }

  // TCP_NODELAY. Without it the stack holds a small trailing piece of data back
  // until the receiver has acknowledged the data before it, and the receiver
  // (Windows) in turn holds its acknowledgement back for up to ~200 ms hoping to
  // piggyback it. The two waits together showed up as frames that arrived in
  // bursts with 100-400 ms holes between them. Each chunk below is sent whole, so
  // there is nothing to gain by letting the stack wait.
  int sock = httpd_req_to_sockfd(req);
  int one = 1;
  setsockopt(sock, IPPROTO_TCP, TCP_NODELAY, &one, sizeof(one));

  esp_err_t res = httpd_resp_set_type(req, STREAM_CONTENT_TYPE);
  if (res != ESP_OK) return res;

  uint8_t* out = (uint8_t*)heap_caps_malloc(STREAM_BUF_BYTES, MALLOC_CAP_SPIRAM);  // NULL is fine
  const size_t blen = strlen(STREAM_BOUNDARY);
  char partHeader[64];
  while (true) {
    camera_fb_t* fb = esp_camera_fb_get();
    if (!fb) {
      res = ESP_FAIL;
    } else {
      const size_t len = fb->len;
      const size_t hlen = snprintf(partHeader, sizeof(partHeader), STREAM_PART_HEADER, (unsigned)len);
      if (out && blen + hlen + len <= STREAM_BUF_BYTES) {
        // One chunk per frame, and the camera's buffer goes back to the driver
        // as soon as it is copied, so the sensor can already be capturing the
        // next frame while this one is still on its way out.
        memcpy(out, STREAM_BOUNDARY, blen);
        memcpy(out + blen, partHeader, hlen);
        memcpy(out + blen + hlen, fb->buf, len);
        esp_camera_fb_return(fb);
        res = httpd_resp_send_chunk(req, (const char*)out, blen + hlen + len);
      } else {
        res = httpd_resp_send_chunk(req, STREAM_BOUNDARY, blen);
        if (res == ESP_OK) res = httpd_resp_send_chunk(req, partHeader, hlen);
        if (res == ESP_OK) res = httpd_resp_send_chunk(req, (const char*)fb->buf, len);
        esp_camera_fb_return(fb);
      }
    }
    // A closed connection (app disconnected, or the backend's proxy gave
    // up) makes httpd_resp_send_chunk fail — that's the normal, expected
    // way this loop ends, not an error to recover from.
    if (res != ESP_OK) break;
  }
  if (out) heap_caps_free(out);
  return res;
}

void startCameraServer() {
  httpd_config_t config = HTTPD_DEFAULT_CONFIG();
  httpd_uri_t streamUri = {
    .uri = "/stream",
    .method = HTTP_GET,
    .handler = streamHandler,
    .user_ctx = NULL,
  };
  if (httpd_start(&streamHttpd, &config) == ESP_OK) {
    httpd_register_uri_handler(streamHttpd, &streamUri);
    Serial.println("Stream server started on /stream");
  } else {
    Serial.println("Stream server failed to start");
  }
}

// How many times initCamera() is retried before the board gives up and
// reboots, and how long to wait between attempts.
const int CAMERA_INIT_ATTEMPTS = 5;
const unsigned long CAMERA_RETRY_DELAY_MS = 500;

// Blocks until the network is up. WiFi.begin() keeps retrying by itself, so
// an access point that's down at boot resolves itself when it comes back —
// nothing here has to handle that case.
void connectWiFi() {
  WiFi.begin(ssid, password);
  Serial.print("Connecting to WiFi");
  while (WiFi.status() != WL_CONNECTED) {
    delay(500);
    Serial.print(".");
  }
  Serial.println("\nWiFi connected!");
  Serial.print("My IP: ");
  Serial.println(WiFi.localIP());

  // Power save off. The default (modem sleep) lets the radio doze between the
  // router's beacons, so a packet addressed to this board can wait up to a
  // beacon interval (~100 ms) before the board even hears it, and every TCP
  // acknowledgement for the stream waits the same way. Measured on this board
  // with it on: ping time 5-80 ms, and a worst gap between stream frames of
  // 717 ms (340 ms with it off, in the same dim room). The cost is a little more
  // current, which a board that streams video is already drawing. Done after
  // the connection is up, because the WiFi driver applies its own default when
  // it starts.
  WiFi.setSleep(false);
  wifi_ps_type_t ps = WIFI_PS_MAX_MODEM;
  if (esp_wifi_get_ps(&ps) == ESP_OK) {
    Serial.printf("WiFi power save: %s\n", ps == WIFI_PS_NONE ? "off" : "STILL ON");
  }
}

void setup() {
  // Cheap USB power (a marginal cable/hub, or a port shared with other
  // devices) can sag enough during the camera's init current spike to trip
  // the brownout detector and reset the board right as it's booting — a
  // known ESP32-CAM failure mode, not specific to this sketch. Disabling it
  // trades that false-positive protection for actually being able to boot;
  // the camera drawing real excess current would still show up as a hang or
  // corrupt frames, just not as a brownout reset loop.
  WRITE_PERI_REG(RTC_CNTL_BROWN_OUT_REG, 0);

  Serial.begin(115200);
  Serial.println();

  // WiFi first, camera second — deliberately the opposite of how this
  // started out. initCamera() used to run before WiFi.begin(), and its
  // failure path was `while (true) delay(1000)`, so a camera that didn't come
  // up meant the board never joined the network at all: no frames, no
  // /stream, and no heartbeat either (this board sends none by design — its
  // frames are its heartbeat, see esp32/README.md), with nothing anywhere to
  // reboot it. The Arduino loop task isn't subscribed to the task watchdog,
  // and delay() yields anyway, so that halt was permanent and silent. One
  // loose ribbon connector — made likelier by the brownout detector being
  // masked just above — took the camera off the air until a human noticed.
  // Connecting first at least puts the board on the network before anything
  // can fail.
  connectWiFi();

  // Bounded retry instead of a halt. A ribbon that didn't seat on the first
  // attempt often reads fine a moment later; if the camera really is gone,
  // rebooting is the only recovery this board has, and a reboot loop is at
  // least visible — on the serial console, and as a board that keeps
  // reappearing on the network without ever sending a frame.
  bool cameraReady = false;
  for (int attempt = 1; attempt <= CAMERA_INIT_ATTEMPTS && !cameraReady; attempt++) {
    cameraReady = initCamera();
    if (!cameraReady) {
      Serial.printf("Camera init attempt %d of %d failed.\n", attempt, CAMERA_INIT_ATTEMPTS);
      // A failed esp_camera_init() leaves the driver half-allocated, so
      // without this the retry fails on the leftovers rather than on the
      // hardware it is actually meant to be testing.
      esp_camera_deinit();
      delay(CAMERA_RETRY_DELAY_MS);
    }
  }

  if (!cameraReady) {
    Serial.printf("FATAL: camera init failed %d times — restarting.\n", CAMERA_INIT_ATTEMPTS);
    Serial.flush();  // esp_restart() doesn't drain the UART on its way out
    delay(1000);
    esp_restart();
  }
  Serial.println("Camera ready.");
  Serial.printf("Sending a frame to %s:%d every %lums\n", backendHost, backendPort, CAPTURE_INTERVAL_MS);

  startCameraServer();
}

void loop() {
  // sendBackoffMs stretches the interval while the backend is refusing frames
  // or unreachable; it is zero the rest of the time, which is almost always.
  if (millis() - lastCapture >= CAPTURE_INTERVAL_MS + sendBackoffMs) {
    // Stamped BEFORE the send: the interval is the time between the starts of
    // two pushes. Stamped after, it was the interval plus however long the
    // backend took to answer (recognition included), which made the real rate
    // about 1.3 a second instead of the 2 the interval says.
    lastCapture = millis();
    if (WiFi.status() == WL_CONNECTED) {
      noteSendResult(sendFrame());
    }
  }

  // Yield. Without this the loop task spins at 100% CPU through the entire
  // inter-frame gap: the core only inserts an automatic yield into loop() on
  // a single-core build (CONFIG_FREERTOS_UNICORE), which this chip is not, so
  // a priority-1 task that never blocks starves the idle task and competes
  // with the stream task and the WiFi stack for a core it isn't using for
  // anything.
  delay(10);
}
