yairbon/HomeGuard/(commit log)

2026-08-02 Initial commit: HomeGuard hybrid security system
    Flutter Android app, FastAPI backend with OpenCV face recognition, and
    3 independent ESP32 boards (ultrasonic, door+keypad, vibration). Custom
    dark control-panel UI with a literal circuit-schematic status hero,
    hand-drawn icon set, and real backend integration end-to-end.
2026-08-07 Close the open-alarm hole, harden the backend, upgrade face recognition
    Every endpoint was unauthenticated. `POST /disarm` with no credentials
    returned 200, so anyone who could reach the backend — over the Tailnet, the
    LAN, or the USB tunnel — could disarm an armed alarm without knowing the
    password. `/login` verified a password and then nothing ever checked identity
    again. `/change-password` enforced no attempt limit at all, making it an
    unthrottled oracle for guessing the password that `/login`'s 3-attempt
    lockout was supposed to protect.
    Authentication
    - Session tokens: `/login` issues a 12h `secrets.token_urlsafe` token, sent
    as `Authorization: Bearer`. Every mutating/state-exposi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
2026-08-07 Add push notifications, a camera worker, and make three dead settings real
    Three features that were built but inert, and one gap that made the alarm
    useless when it mattered most.
    Push notifications (ntfy)
    The app's own notifications only fire while its process is alive, so a
    break-in while the app was swiped away produced nothing at all. backend/
    notifier.py POSTs to an ntfy topic, which the ntfy Android app receives
    independently. Chosen over FCM because FCM needs a Firebase project and a
    google-services.json only the owner can create, and adding the Gradle plugin
    without that file breaks the Android build outright — ntfy needs no account,
    no new Flutter dependency, and no build change.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
2026-08-20 Add the ESP32-CAM board with a live MJPEG feed, and fix three hardware gaps
    Everything here came out of bringing the physical boards up on real
    hardware for the first time, so it spans firmware, backend and app.
    Fourth board: the ESP32-CAM
    esp32/esp32_cam/ pushes frames to /camera/recognize (same request the
    existing camera_worker.py sends, so the backend can't tell them apart)
    and additionally serves its own MJPEG /stream. The backend proxies that
    through to the app at GET /camera/stream, and the camera screen renders
    it live instead of showing a static placeholder. Measured 21 fps VGA
    end to end over Tailscale.
    Three things in that chain are easy to break and are commented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
2026-08-21 Fix nine audit defects, and add keypad-PIN changes from the app
    Two workstreams. Every gate below was run on this commit.
    ## The nine fixes (all from the audit, all SAFE-tagged)
    Backend — six defects, none of them inside a single function; each is a
    gap between two pieces that are individually correct:
    * `_broadcast` iterated the live socket set across an `await`. A phone
    disconnecting mid-broadcast raised `RuntimeError: Set changed size during
    iteration`, which the `except` did not cover: the alarm frame was lost for
    every socket past the mutation point, `/esp32/sensor-event` answered the
    reporting board with a 500, and the same escape out of `_monitor_boards`
    killed board li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
2026-08-21 Fix the remaining audit findings across all three components
    Second and final pass over the audit backlog. 30 of the 34 findings are now
    fixed outright, 3 are mitigated, and 1 is deliberately left open.
    ## The alarm can no longer be defeated silently
    * **Entry delay had no backend deadline.** `begin_entry_delay` stored an
    expiry nothing ever fired on, so escalation depended entirely on the door
    controller surviving to report. Cutting that board's power mid-countdown
    was a total, silent bypass: no `triggered`, no push, nothing, ever. There
    is now a cancellable watchdog, cancelled on every exit from the state.
    * **The entry-delay countdown never counted.** The backend broadcasts the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
2026-08-24 Close the three findings that were only mitigated
    Follow-up to c0224b0. Each of these had its damage contained but not its
    cause removed; this removes the causes.
    ## The door controller no longer blocks itself while reporting
    Capping the outbound HTTP timeouts shrank the window in which this board
    answers nothing — it did not remove it. `loop()` calls
    `server.handleClient()` once per pass, so for the whole duration of any
    report the board replies to neither `/arm`, `/disarm`, nor `/trigger-alarm`,
    which the backend calls with a 3-second budget when a *different* board
    reports a break-in. It also drops physical keypresses outright, since
    `getPhysicalKey()` has no buffer and only sees a ke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
2026-09-03 Add a motion-based liveness check before a recognized face can disarm
    SFace matches embeddings only, so a printed photo or a phone-screen
    photo held up to the camera could disarm the alarm same as a live
    person. YuNet already returns 5 facial landmarks on every detection
    for free; this tracks a short rolling window of them per face_id and
    requires visible micro-jitter (a live person is never perfectly
    still) before treating a match as live enough to disarm.
    Recognizing a face while not live still logs and broadcasts as
    before -- only the disarm itself is gated on `live`, rate-limited by
    the same FACE_LOG_COOLDOWN as the rest of face-recognition logging.
2026-09-03 Merge the app login password and the keypad PIN into one shared code
    The project owner explicitly asked for the app password and the
    physical keypad's disarm PIN to become the same credential instead
    of two. This is a real security trade-off, not just convenience: the
    app password used to be free-form and scrypt-hashed, while the
    keypad PIN was constrained to 4-8 digits because that's all a 4x4
    keypad can type. The weaker shape now wins for both -- documented
    plainly in this diff rather than buried, per the owner's explicit
    sign-off on the trade-off.
    POST /change-password is now the single endpoint for both; the old
    POST /settings/keypad-pin is removed rather than left as a second
    path that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
2026-09-03 Add a second force sensor to the ultrasonic board, for a window
    Same SW-420-style digital sensor as esp32/vibration_sensor, wired to
    GPIO 27 on the ultrasonic board instead of a fifth standalone board,
    since it sits physically next to it at a nearby window. Reuses the
    existing sensor=vibration category (this is the same class of
    device, just a second instance) so no backend or app changes were
    needed -- Home-mode bypass and every other sensor=vibration code
    path already applies to it.
    Copies the interrupt-driven latch pattern from vibration_sensor.ino
    rather than polling, for the same reason documented there: a
    SW-420's pulse burst can be shorter than a polling interval, so
    polling can miss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
2026-09-03 Add the MiniFASNetV2 anti-spoofing model, not yet wired in
    Second, stronger layer planned on top of the motion-based liveness
    check: a dedicated anti-spoofing model (live/print-attack/replay-
    attack classification) rather than a jitter heuristic. Same
    OpenCV-DNN-plus-ONNX pattern already used for yunet.onnx/sface.onnx,
    so no new dependency.
    Unlike those two, there's no single official model-zoo source for
    this one -- the original project (minivision-ai/Silent-Face-Anti-
    Spoofing, Apache-2.0) only publishes PyTorch/Caffe weights. This
    ONNX export is a third-party conversion (garciafido/minifasnet-v2-
    anti-spoofing-onnx on Hugging Face), fetched with the project
    owner's explicit go-ahead afte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
2026-09-08 Load the persisted keypad PIN back from NVS on boot
    loadKeypadPin() existed and was fully correct -- reads the PIN saveKeypadPin()
    wrote to NVS, falls back to the secrets.h default if nothing valid is
    stored -- but setup() never called it. A PIN changed from the app updated
    the in-RAM secretPin for the rest of that boot (so it worked immediately),
    but the next power cycle re-initialized secretPin from the compiled-in
    KEYPAD_PIN default, silently reverting to the factory PIN. This directly
    contradicted the comment already sitting above secretPin, which promised
    a PIN set from the app survives reboots.
    Found auditing the branch before opening its PR, alongside python/backend/
    models.py and es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
2026-09-08 Relay a face-recognition disarm to the door controller hardware
    log_face_recognized() flipped the software alarm state and broadcast it
    over the WebSocket, but never told the physical door controller -- unlike
    the /disarm route, which already follows local-state-then-hardware-command.
    A face disarm looked correct in the app while the board's buzzer kept
    sounding, the same class of bug the _Result.reachable work fixed for the
    app side of DISARM earlier on this branch.
    Mirrors /disarm's own pattern: esp32_client is deferred-imported here
    because it imports `state` at module level, so importing it at the top of
    this file would be circular.
    Confirmed live: a WARNING:esp32_client:Door controlle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
2026-09-08 Wire the MiniFASNetV2 anti-spoofing model into the liveness check
    Follow-up to the model's addition (previous commit): is_live() now
    requires both the existing motion-based check and a MiniFASNetV2 verdict
    to agree before a recognized face can disarm. Defense in depth, not
    redundancy -- the motion check alone was confirmed beatable live (a
    photo jiggled by hand carries enough incidental jitter to pass it), while
    the model is trained to see the print/screen texture that same jiggled
    photo still carries.
    _DnnBackend now loads minifasnet_v2.onnx alongside yunet/sface (falling
    back to motion-only, with a warning, if the file is missing) and runs it
    on the region recognize() already found, expan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
2026-09-08 Fix documentation and comments left stale by this branch
    Pre-PR audit pass across all three components (esp32/, python/, app/),
    looking for dead code, debug leftovers, and drift between docs/comments
    and what the code actually does now. No dead code or debug leftovers
    turned up -- what did was a handful of places this branch's real changes
    left behind stale claims:
    - backend/models.py and a test docstring still pointed at
    app/lib/services/backend_service.dart as where the JSON wire format
    lives; that's actually the abstract interface with no wire keys in it,
    http_backend_service.dart is the real target. python/README.md already
    had this fixed in one place but not the other two.
    - py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
2026-09-08 Warn at startup when a board's secrets.h has a stale BACKEND_HOST
    This project's single most recurring hardware-bringup problem, restated
    today for the fourth time: the dev machine's WiFi network reassigns its IP
    by DHCP, often between sessions, and every ESP32 board's secrets.h has that
    IP compiled in as a literal. When it drifts, a board doesn't error -- it
    just can't reach the backend, and shows up in the app as "offline",
    indistinguishable from a board that lost power or WiFi. Nothing short-
    circuited that diagnosis before; it always took re-deriving "is this a
    power problem or an IP problem?" by hand.
    ip_check.py reads BACKEND_HOST out of each of the four esp32/*/secrets.h
    files, compa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
2026-10-15 Showcase prep: email alerts with camera photo, shared camera hub, door-open arm refusal, ESP32-CAM streaming fixes
    Backend: email alerts (Gmail SMTP, recipients and master switch editable in the app, camera picture attached), one shared connection to the camera for any number of viewers, visible-console logging, faces folder follows the state file, web app served by the backend. App: alerts settings, still-image fallback for Safari, same-origin web defaults, HomeGuard icons. Door board: remote arm refused with the door open, sound system, no Serial keypad in shipped builds. Scripts and docs: backend launcher, web build, alert helpers, data backup, demo shot list.
    NOT TESTED ON HARDWARE: esp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
2026-10-15 Add final report part 2 (design and implementation) and correct part 1 facts
    Part 1 corrected against the current code: keypad is 3x4, the backend
    state machine has five states, and liveness checks (landmark motion +
    MiniFASNetV2) exist.
    Claude-Session: https://claude.ai/code/session_01N3vMpjMW2wYwoiVm9vYhWU
2026-10-15 Add final report part 3: tests and results, summary, BOM, consolidated bibliography
    Test figures were re-measured for the report: 258 pytest tests and 98
    live end-to-end checks pass, ruff clean. Part 1 and 2 counts updated.
    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
2026-10-17 Rewrite the report: shorter, plain language, matches the final system
    Applies the partner's review: three ESP32 boards (distance and vibration
    sensors share one), email alerts only, no Tailscale/ntfy/liveness, 30 s
    entry delay, no 3 s arming delay, Home mode ignores distance + vibration
    sensors, keypad arming and keypad explanation, full list of buzzer sounds,
    realistic security section, trimmed tests chapter, two diagrams only, BOM
    without purchase links, and sequentially numbered, verified references.
    The 13-page Word file is built from report/HomeGuard_Report.md.
    Claude-Session: https://claude.ai/code/session_01N3vMpjMW2wYwoiVm9vY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
2026-10-17 Restore the sections that were cut too far: intrusion walkthrough, face recognition, results with evidence slots, limits and short design reasons
    The report grows from 13 to 15 pages. No pin lists, test counts or
    code walkthroughs were added back.
    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
2026-10-17 Expand the report to 18 pages: app screens, alerts and night mode, key values table, quick-start appendix; correct the sensor-fault claim
    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
2026-10-17 Fix report errors found in a code audit: screen count, summary contradiction, camera liveness, entry-delay watchdog timing, keypad disarm rules
    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
2026-10-20 Adapt the report to the code: Home mode bypasses only the vibration sensor, 3 s arming from the app, deviations from the proposal, lockout wording
    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
2026-10-20 Home mode now ignores both sensor-board sensors (distance and vibration); drop ntfy and the four-board wording from the README; report follows the code
    The backend bypasses the distance and vibration sensors in Home mode, the door
    sensor stays active. Tests and the real-server simulation cover the new rule.
    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
2026-10-20 Remove the Tailscale hint from the app's settings text and the esp32 README; keep CLAUDE.md out of the submission ZIP
    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
2026-10-21 Expand the operating guide: split table 9 into keypad+app and app-only tables with step-by-step instructions and the real button names
    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
2026-10-21 Apply the review findings: 12 factual text fixes, challenges as short stories, Hebrew figures with a distance-sensor flowchart and five alarm states, 'קטע קוד N' captions, remove dangling CLAUDE.md r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
2026-10-21 Home mode skips both perimeter sensors; alarm email carries a video clip with an app setting; box STLs
    Home mode now bypasses ultrasonic and vibration (door stays live). The backend watches the camera stream while the new clip switch is on, keeps the last 60 s, and attaches an H.264 MP4 (ffmpeg via imageio-ffmpeg, OpenCV fallback) to the breach email and the test alert; Settings has a switch and a 5-60 s length. PIN section relabelled. build-web.ps1 no longer stops on Flutter's deprecation warning. Adds the printed enclosure's STL files and generator scripts. Backend: 362 pytest pass, ruff clean; app: analyze clean, 14 tests pass. No firmware change needed.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
2026-10-21 Add the distance-sensor Serial Plotter graph as figure 7; no figure placeholders remain
2026-10-21 Door WiFi fix, ultrasonic plot stream, backend learns board addresses, real-frame clip pacing, deadline countdown, NOT CONNECTED badges
    Firmware as flashed today: door board (WiFi power save off, strongest AP, reconnect watchdog, seconds-left entry report, Home arms at once) and ultrasonic board (same WiFi fix, iPhone-hotspot probe, plot stream dist/base/thr for the Arduino Serial Plotter, plot mode toggled by p). Backend: learns the door and camera addresses from their own requests, UDP announcer for the boards, clip frames paced once each at the true rate, Home mode arms at once and skips both perimeter sensors. App: entry countdown computed from a deadline, sensor badges say NOT CONNECTED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
2026-10-21 Fill in the bill of materials with the purchased items and prices (total so far 162.41 NIS)
2026-10-21 Complete the bill of materials (total 206.79 NIS, 36.79 over the proposal budget); keep the last rows of a long table together
2026-10-21 Bill of materials: list only the two development boards used in the final system (total 172.38 NIS)
2026-10-21 Bill of materials: the budget was 200 NIS; the proposal's estimate of 170 NIS is kept for comparison
2026-10-21 Section 8.1: remove the paragraph about the budget and the proposal after the bill of materials
2026-10-21 Alarm email can carry a video of the last minute from the camera, set from the app; the report describes it
2026-10-21 Report matches the merged code (Home arms at once, plot mode, NOT CONNECTED, enclosure); tools to put the code ZIP inside the report PDF
2026-10-21 Fix the PDF attachment helper for the current pikepdf API
